bobbymckinney/seebeck_measurement/setup/TE_Poster_2016-07-22/2016-05-19 14.07.44.jpg

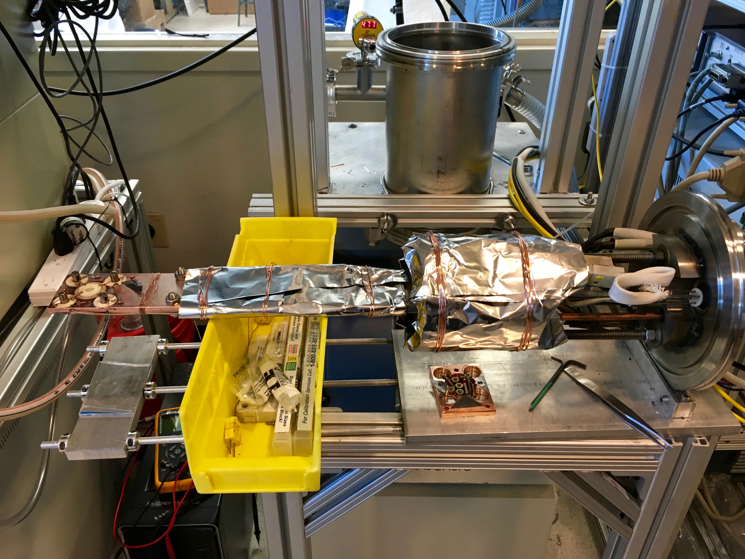
setup/TE_Poster_2016-07-22/2016-05-19 14.07.44.jpg
