bobbymckinney/seebeck_measurement/setup/TE_Poster_2016-07-22/2016-04-12 15.20.03.jpg

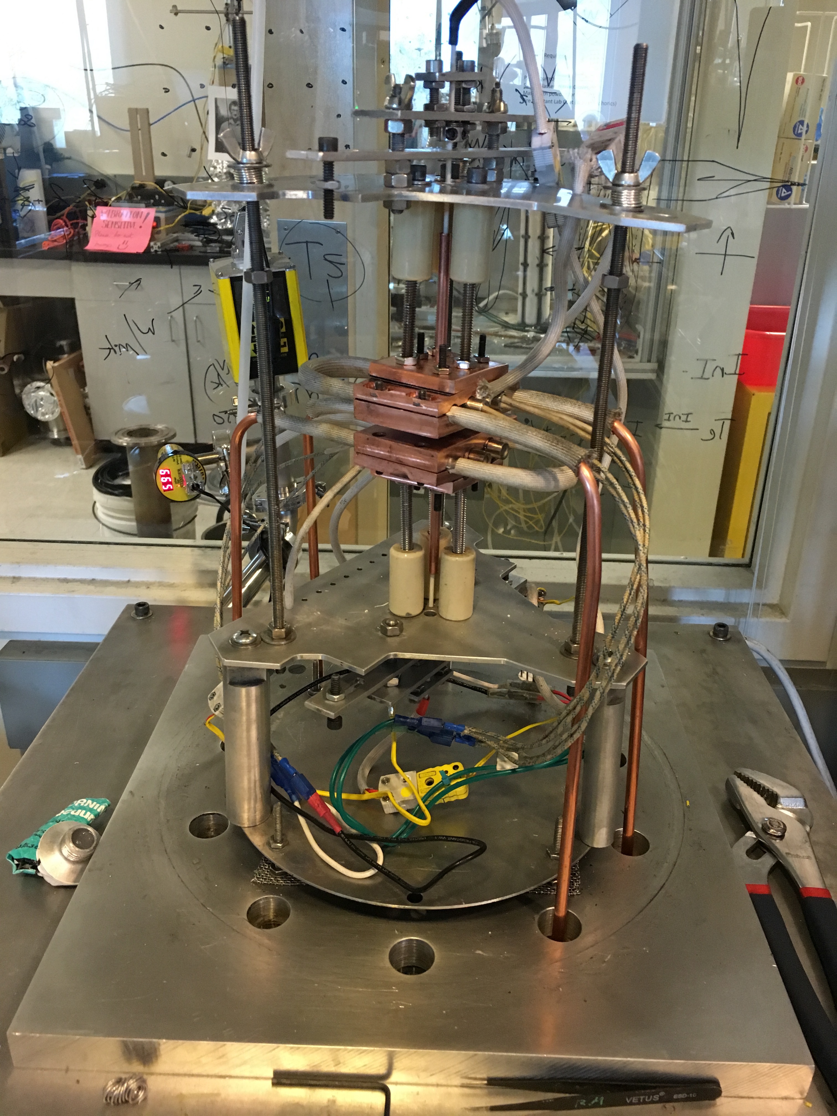
setup/TE_Poster_2016-07-22/2016-04-12 15.20.03.jpg
