bobbymckinney/seebeck_measurement/README.md

# seebeck_measurement

This project is for the measurement of the seebeck coefficient of thermoelectric materials.
