bobbymckinney/seebeck_measurement/program_roomtemp/copper_seebeck_calc/copper_seebeck_fig.png

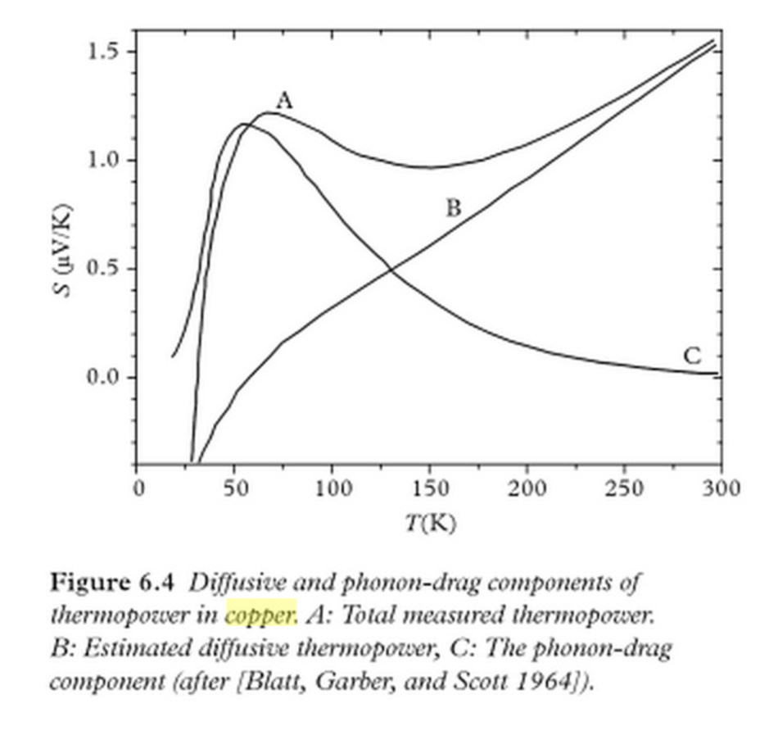
program_roomtemp/copper_seebeck_calc/copper_seebeck_fig.png
