bobbymckinney/seebeck_measurement/program_roomtemp/copper_seebeck_calc/copper_seebeck_fit_plot.png

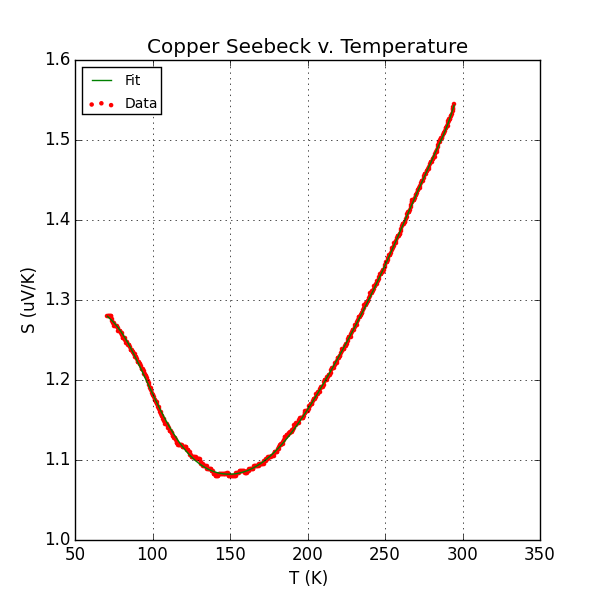
program_roomtemp/copper_seebeck_calc/copper_seebeck_fit_plot.png
