bobbymckinney/seebeck_measurement/programs/Alumel_Seebeck.png

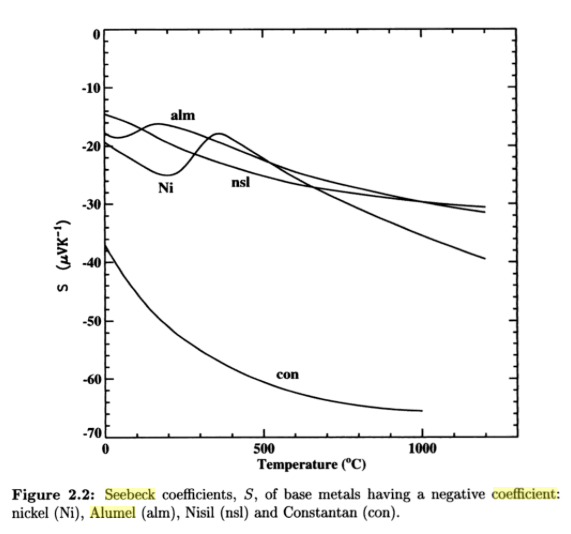
programs/Alumel_Seebeck.png
