bobbymckinney/seebeck_measurement/programs/Chromel_Seebeck.png

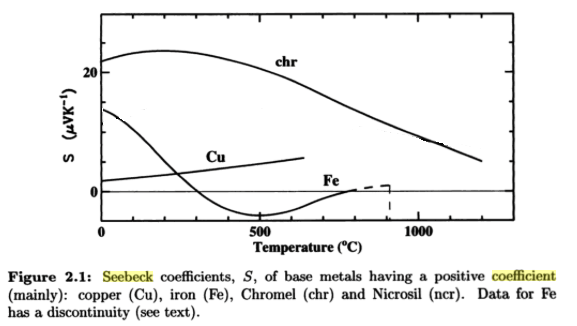
programs/Chromel_Seebeck.png
