bobbymckinney/seebeck_measurement/setup/TE_Poster_2016-07-22/carriertestdata.png

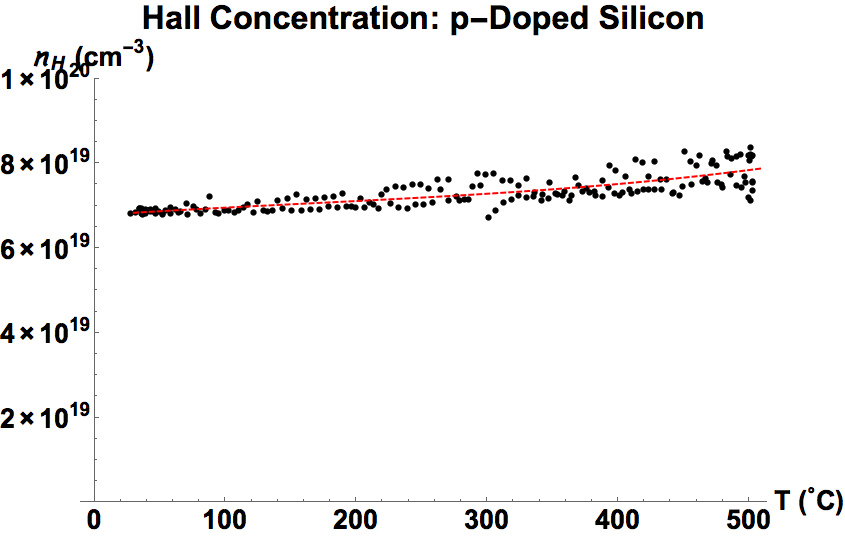
setup/TE_Poster_2016-07-22/carriertestdata.png
