bobbymckinney/seebeck_measurement/setup/hightemp2/seebeck_assembly_whole.SLDASM

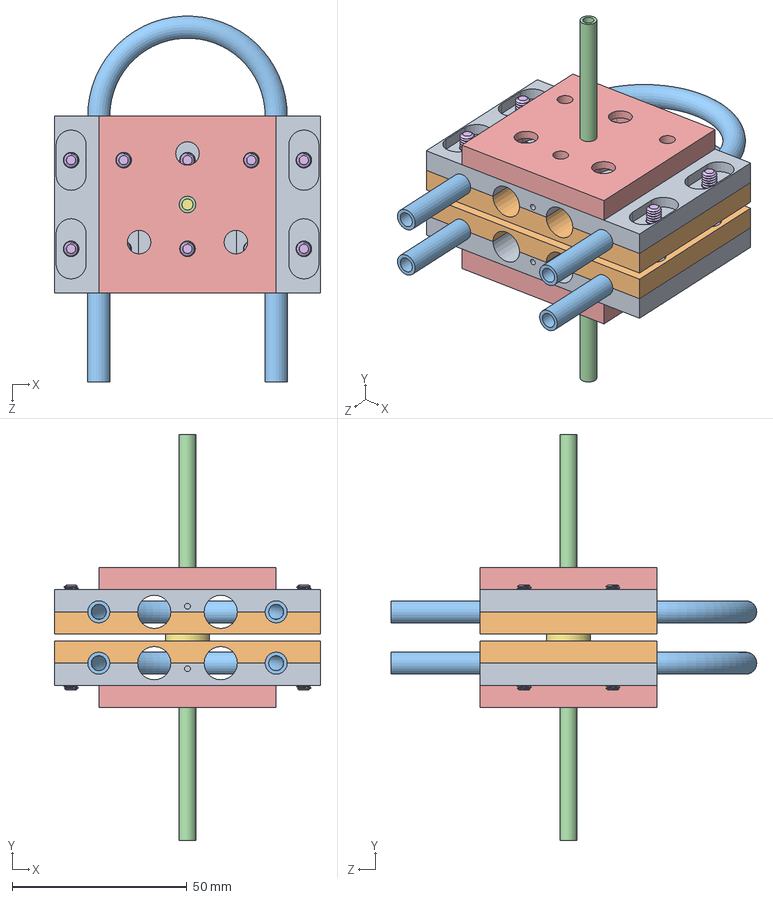
[picture p12: CAD file, 2016-08-10]
setup/hightemp2/seebeck_assembly_whole.SLDASM
76.2 x 116.3 x 104.7 mm
cu_block2 x 2
cu_block1 x 2
cu_tube_cool x 2
cu_tube x 2
ss_block3 x 2
832_screw x 20
example sample
