bobbymckinney/seebeck_measurement/setup/redesign_2-29-16/seebeck_block_assembly.SLDASM

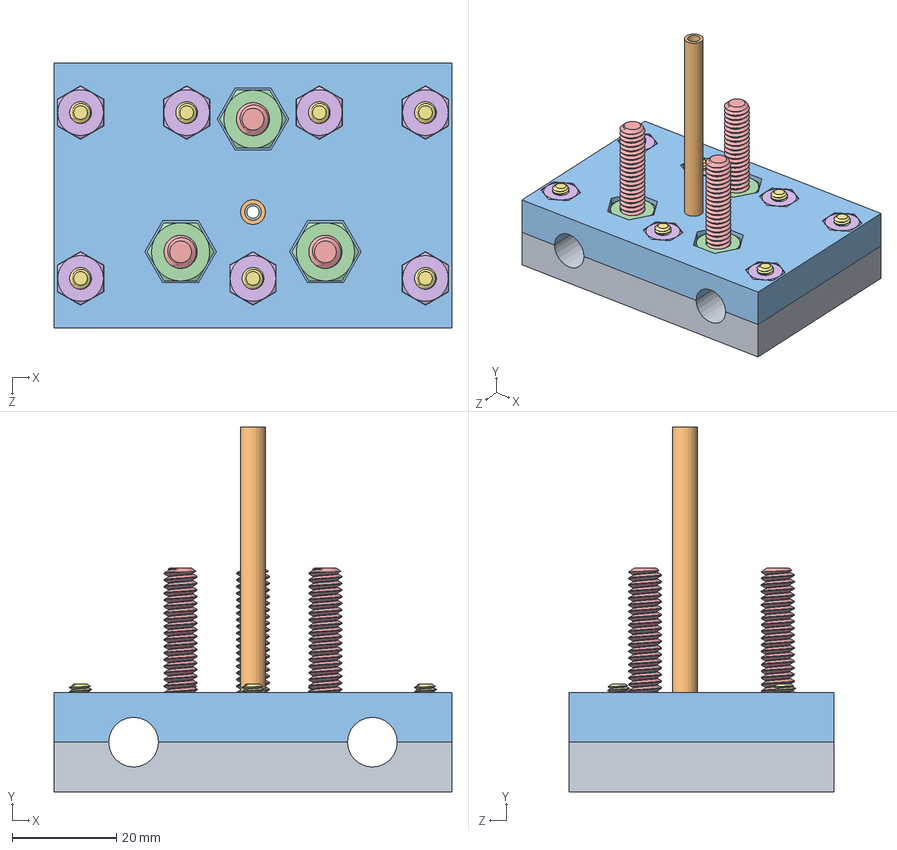
[picture p13: CAD file, 2016-08-10]
setup/redesign_2-29-16/seebeck_block_assembly.SLDASM
76.2 x 69.8 x 50.8 mm
block2
rod
block1
ss_nut_large x 3
ss_screw_large x 3
ss_nut_small x 7
ss_screw_small x 7
