bobbymckinney/seebeck_measurement/setup/hightemp2/seebeck_assembly.SLDASM

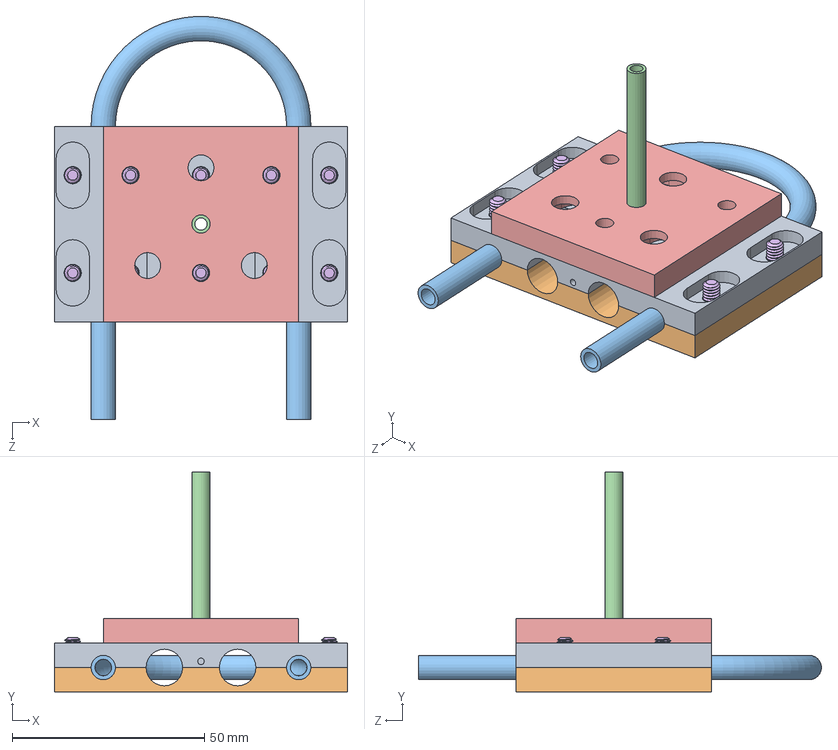
[picture p14: CAD file, 2016-08-10]
setup/hightemp2/seebeck_assembly.SLDASM
76.2 x 57.1 x 104.7 mm
cu_block2
cu_block1
cu_tube_cool
cu_tube
ss_block3
832_screw x 10
