bobbymckinney/seebeck_measurement/setup/lowtemp_design/lowtemp_assmbly.SLDASM

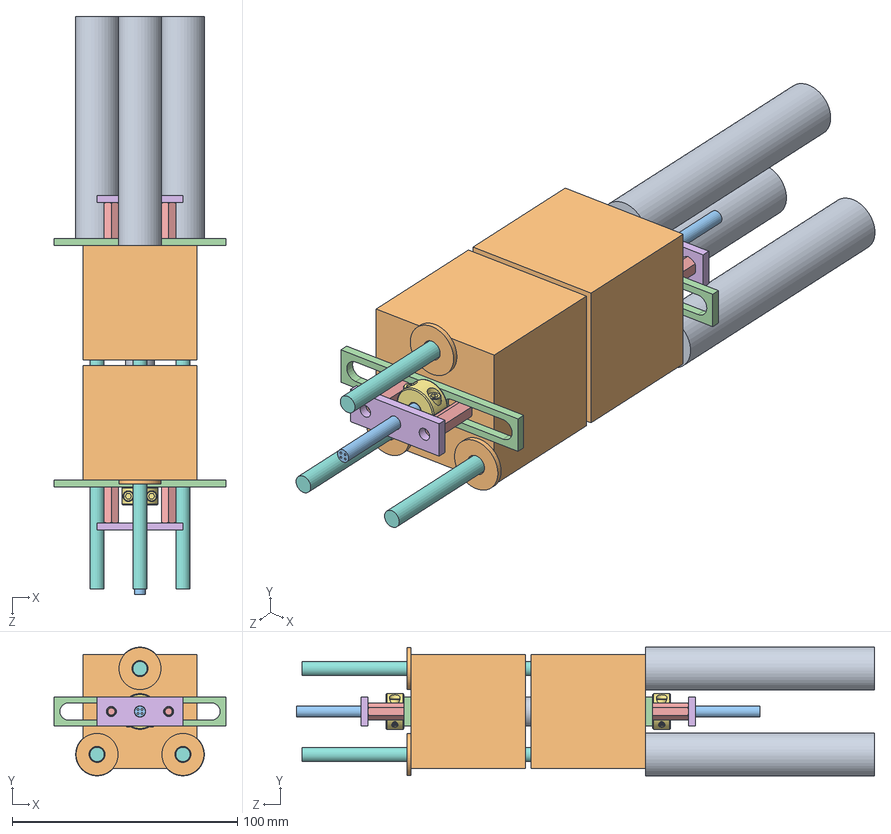
[picture p15: CAD file, 2016-01-14]
setup/lowtemp_design/lowtemp_assmbly.SLDASM
76.2 x 57.1 x 256.5 mm
ceramic_standoff x 3
copper_heater_block x 2
ceramic_thermocouple x 2
aluminum_long_plate x 2
aluminum_standoff x 4
aluminum_short_plate x 2
calmpon_shaft_collar x 2
threaded_rod x 3
example_sample
ceramic_washer x 3
