bobbymckinney/seebeck_measurement/setup/New Seebeck System Parts/New Seebeck System Assembly.SLDASM

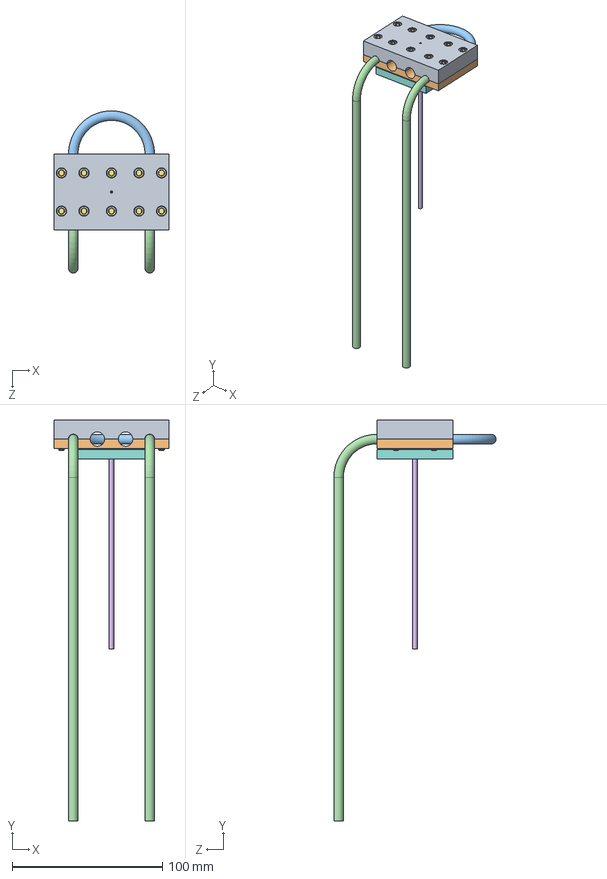
[picture p16: CAD file, 2016-08-10]
setup/New Seebeck System Parts/New Seebeck System Assembly.SLDASM
76.2 x 266.7 x 107.9 mm
Bottom Cu Block
Top Cu Block
Cu Cooling Pipe
Cu Cooling Pipe Extension x 2
Alumina Thermocouple
Copper Thermocouple Housing
832 .625in Length Screw x 10
Stainless Steel Mount
