bobbymckinney/seebeck_measurement/setup/David_test/Al_test1.SLDPRT

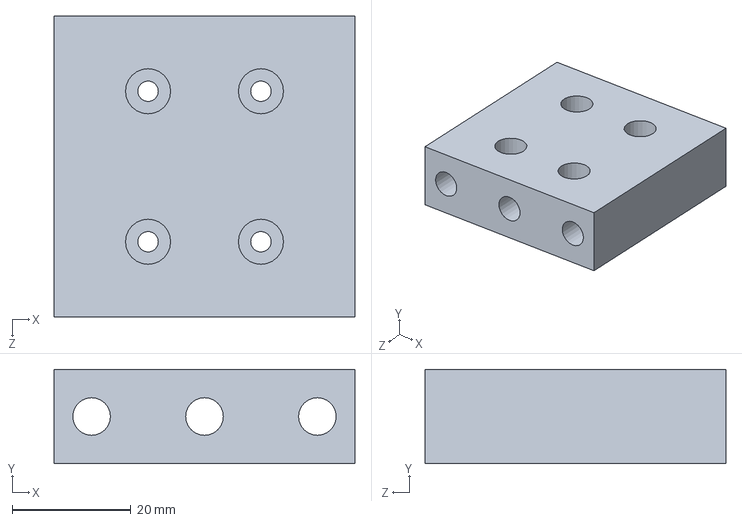
[picture p17: CAD file, 2016-08-10]
setup/David_test/Al_test1.SLDPRT
50.8 x 15.9 x 50.8 mm
