bobbymckinney/seebeck_measurement/setup/hightemp2/mastercam/ss_block3_bottom.SLDPRT

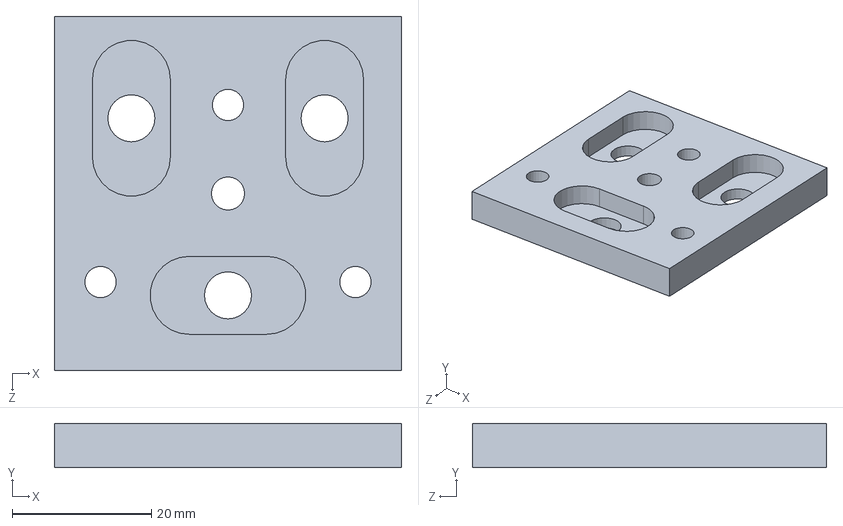
[picture p18: CAD file, 2016-08-10]
setup/hightemp2/mastercam/ss_block3_bottom.SLDPRT
49.8 x 6.35 x 50.8 mm
