bobbymckinney/seebeck_measurement/setup/lowtemp_design/aluminum plate.SLDPRT

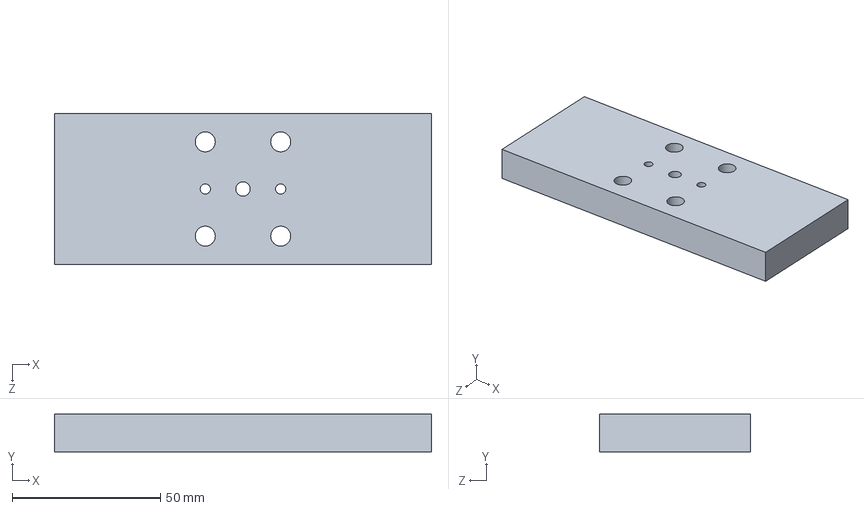
[picture p19: CAD file, 2016-08-10]
setup/lowtemp_design/aluminum plate.SLDPRT
127.0 x 12.7 x 50.8 mm
