bobbymckinney/seebeck_measurement/setup/New Seebeck System Parts/Bottom SS Disk.SLDPRT

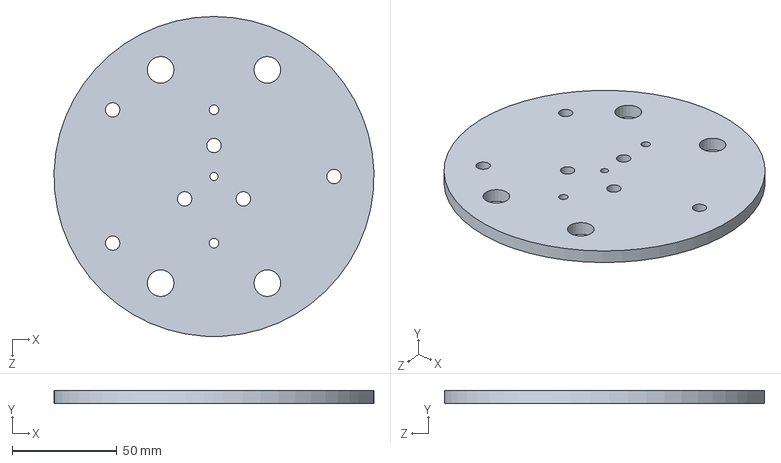
[picture p20: CAD file, 2016-08-10]
setup/New Seebeck System Parts/Bottom SS Disk.SLDPRT
152.3 x 6.35 x 152.4 mm
