bobbymckinney/seebeck_measurement/setup/hightemp2/cu_block2.SLDPRT

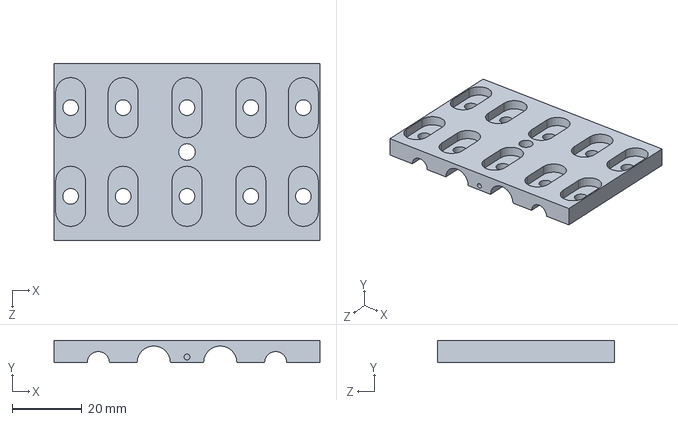
[picture p21: CAD file, 2016-08-10]
setup/hightemp2/cu_block2.SLDPRT
76.2 x 6.35 x 50.8 mm
