bobbymckinney/seebeck_measurement/setup/lowtemp_design/plastic_spacer.SLDPRT

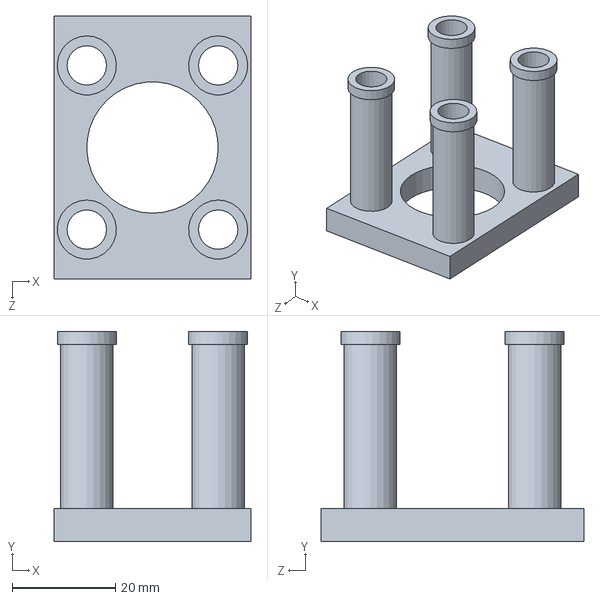
[picture p23: CAD file, 2016-08-10]
setup/lowtemp_design/plastic_spacer.SLDPRT
38.1 x 40.6 x 50.8 mm
