bobbymckinney/seebeck_measurement/setup/New Seebeck System Parts/Copper Thermocouple Housing.SLDPRT

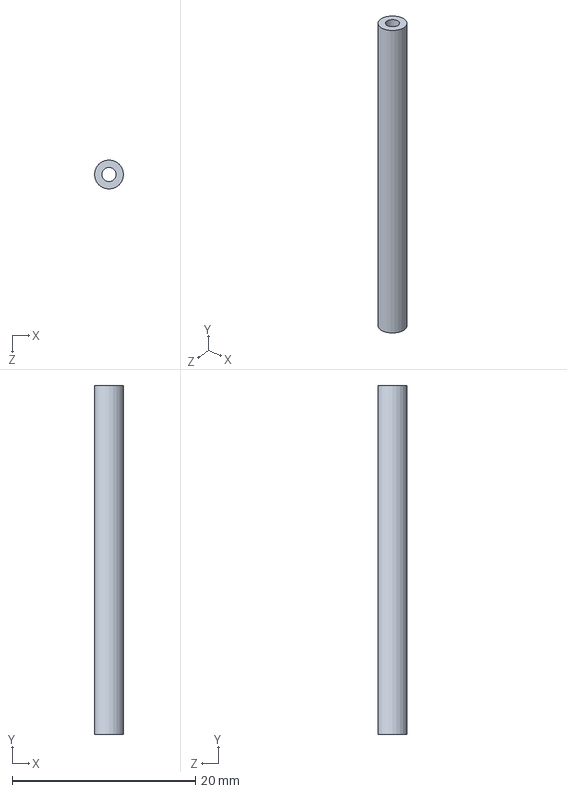
[picture p24: CAD file, 2016-08-10]
setup/New Seebeck System Parts/Copper Thermocouple Housing.SLDPRT
3.17 x 38.1 x 3.17 mm
