bobbymckinney/seebeck_measurement/setup/hightemp2/cu_tube.SLDPRT

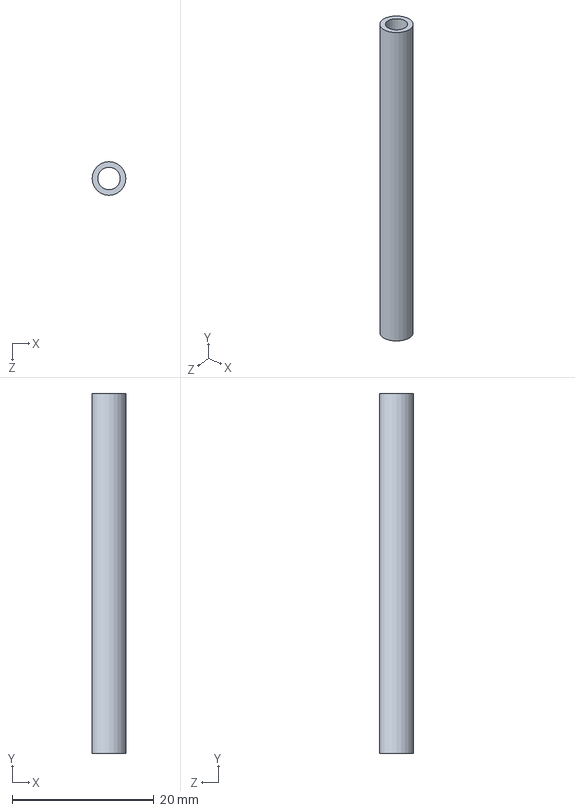
[picture p25: CAD file, 2016-08-10]
setup/hightemp2/cu_tube.SLDPRT
4.76 x 50.8 x 4.76 mm
