bobbymckinney/seebeck_measurement/setup/hightemp2/mastercam/cu_block2_top_holes.SLDPRT

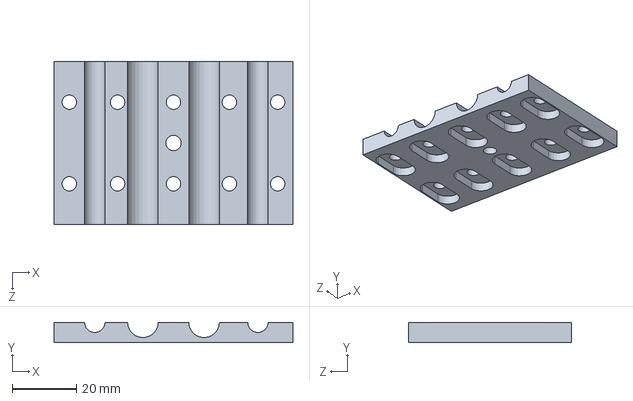
[picture p26: CAD file, 2016-08-10]
setup/hightemp2/mastercam/cu_block2_top_holes.SLDPRT
74.4 x 6.35 x 50.8 mm
