bobbymckinney/seebeck_measurement/setup/lowtemp_design/copper_heater_block.SLDPRT

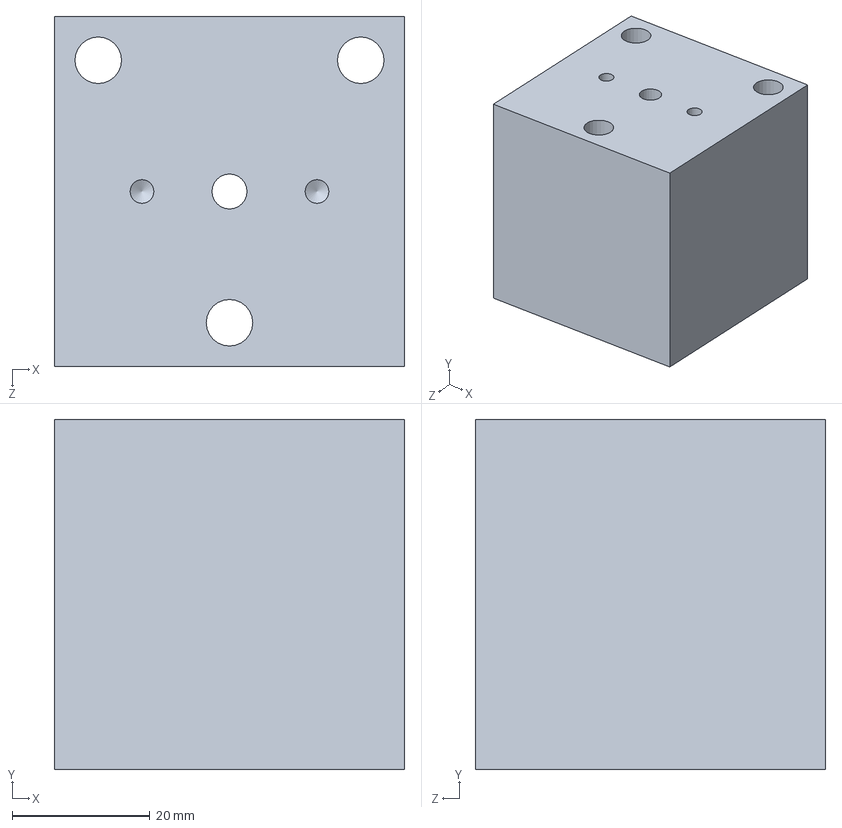
[picture p27: CAD file, 2016-08-10]
setup/lowtemp_design/copper_heater_block.SLDPRT
50.8 x 50.8 x 50.8 mm
