bobbymckinney/seebeck_measurement/setup/lowtemp_design/compression spring.SLDPRT

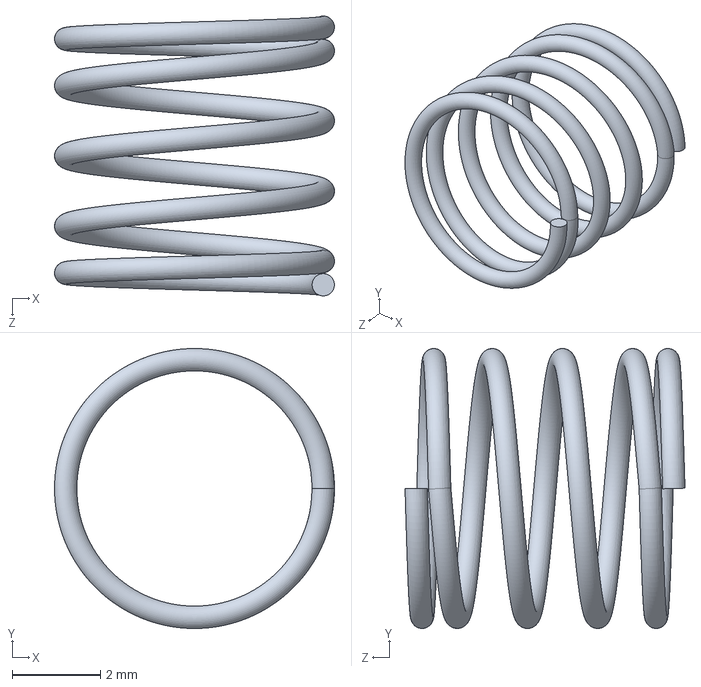
[picture p28: CAD file, 2016-01-14]
setup/lowtemp_design/compression spring.SLDPRT
6.35 x 6.35 x 6.35 mm
