bobbymckinney/seebeck_measurement/setup/hightemp2/example sample.SLDPRT

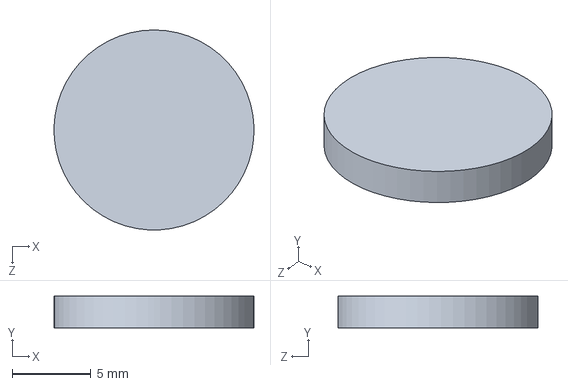
[picture p29: CAD file, 2016-08-10]
setup/hightemp2/example sample.SLDPRT
12.7 x 2.00 x 12.7 mm
