bobbymckinney/seebeck_measurement/setup/lowtemp_design/aluminum_standoff.SLDPRT

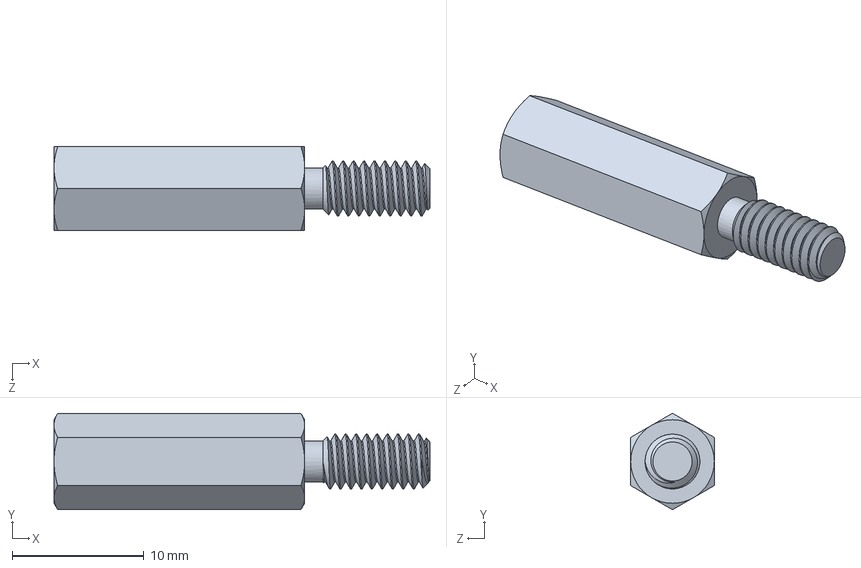
[picture p30: CAD file, 2016-01-14]
setup/lowtemp_design/aluminum_standoff.SLDPRT
28.6 x 7.33 x 6.35 mm
