bobbymckinney/seebeck_measurement/setup/New Seebeck System Parts/Top Thermocouple Bar.SLDPRT

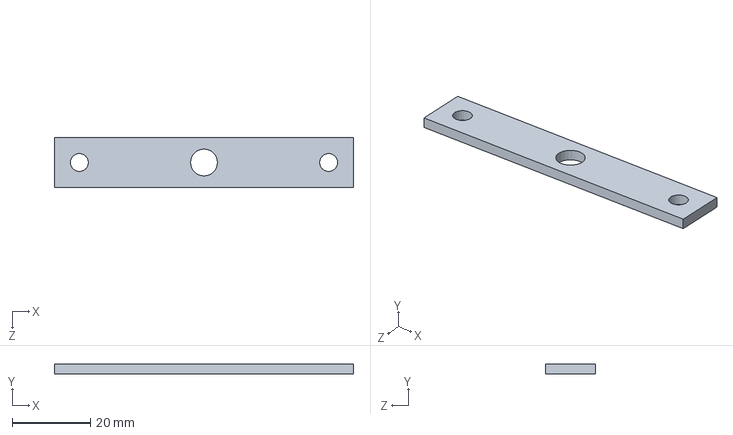
[picture p31: CAD file, 2016-08-10]
setup/New Seebeck System Parts/Top Thermocouple Bar.SLDPRT
76.2 x 2.54 x 12.7 mm
