bobbymckinney/seebeck_measurement/setup/redesign_2-29-16/rod.SLDPRT

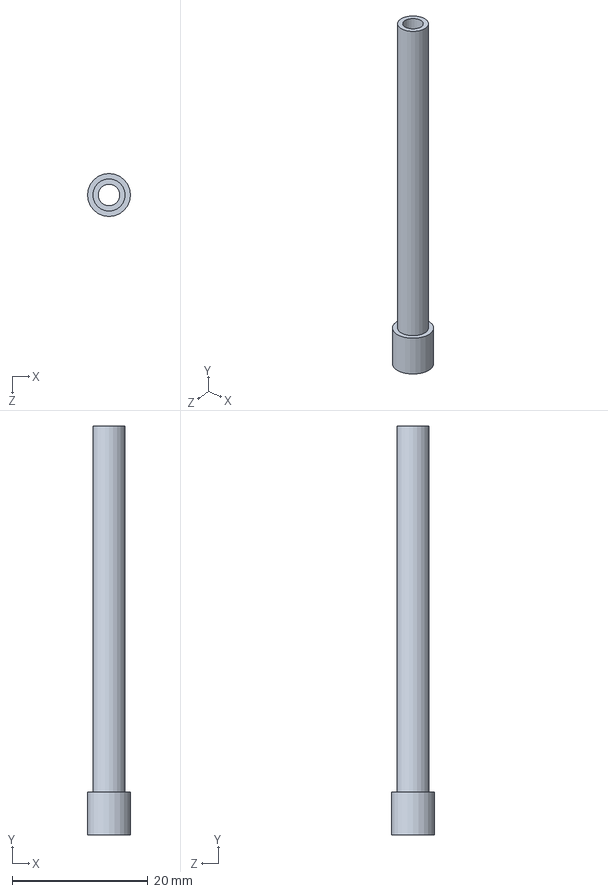
[picture p32: CAD file, 2016-08-10]
setup/redesign_2-29-16/rod.SLDPRT
6.35 x 60.3 x 6.35 mm
