bobbymckinney/seebeck_measurement/setup/hightemp2/ss_block3.SLDPRT

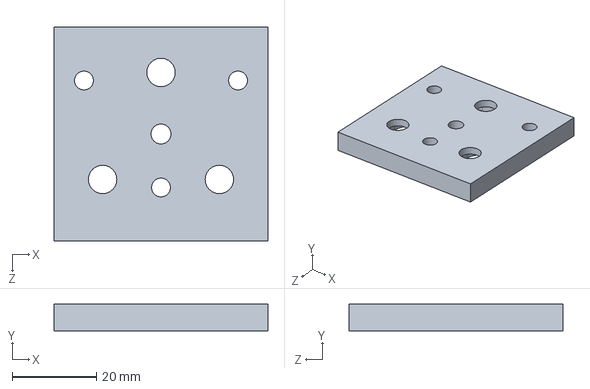
[picture p33: CAD file, 2016-08-10]
setup/hightemp2/ss_block3.SLDPRT
50.8 x 6.35 x 50.8 mm
