bobbymckinney/seebeck_measurement/setup/New Seebeck System Parts/New Flange ISO250.SLDPRT

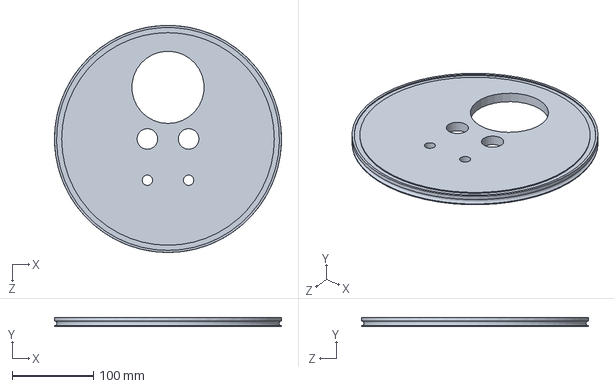
[picture p34: CAD file, 2016-08-10]
setup/New Seebeck System Parts/New Flange ISO250.SLDPRT
279.3 x 11.1 x 279.3 mm
