bobbymckinney/seebeck_measurement/setup/lowtemp_design/aluminum_short_plate.SLDPRT

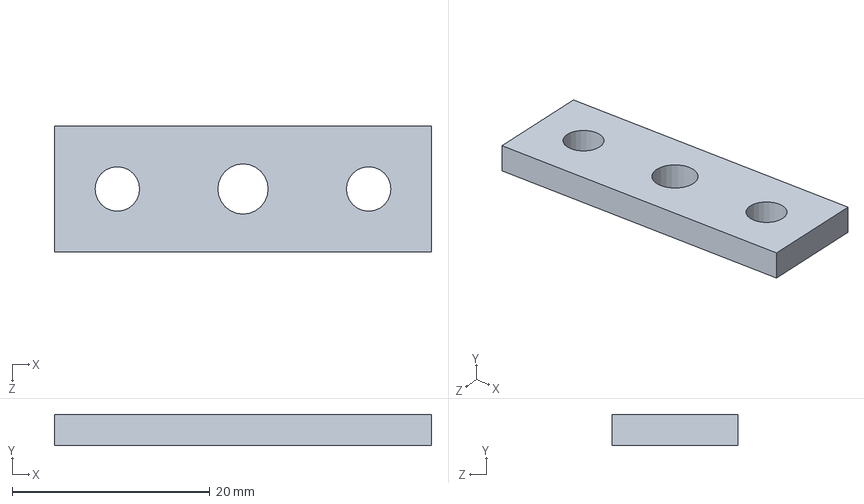
[picture p35: CAD file, 2016-01-14]
setup/lowtemp_design/aluminum_short_plate.SLDPRT
38.1 x 3.17 x 12.7 mm
