bobbymckinney/seebeck_measurement/setup/lowtemp_design/example_sample.SLDPRT

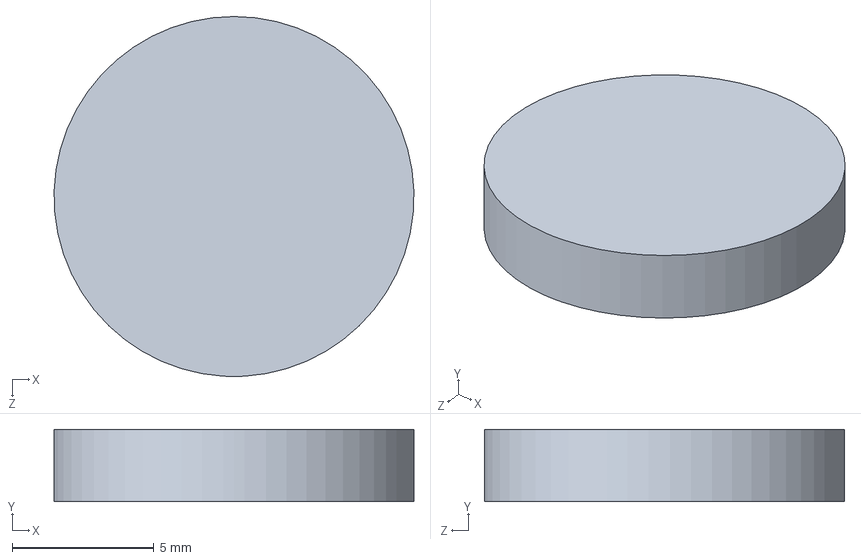
[picture p36: CAD file, 2016-01-14]
setup/lowtemp_design/example_sample.SLDPRT
12.7 x 2.54 x 12.7 mm
