bobbymckinney/seebeck_measurement/setup/New Seebeck System Parts/SS .5in Standoff.SLDPRT

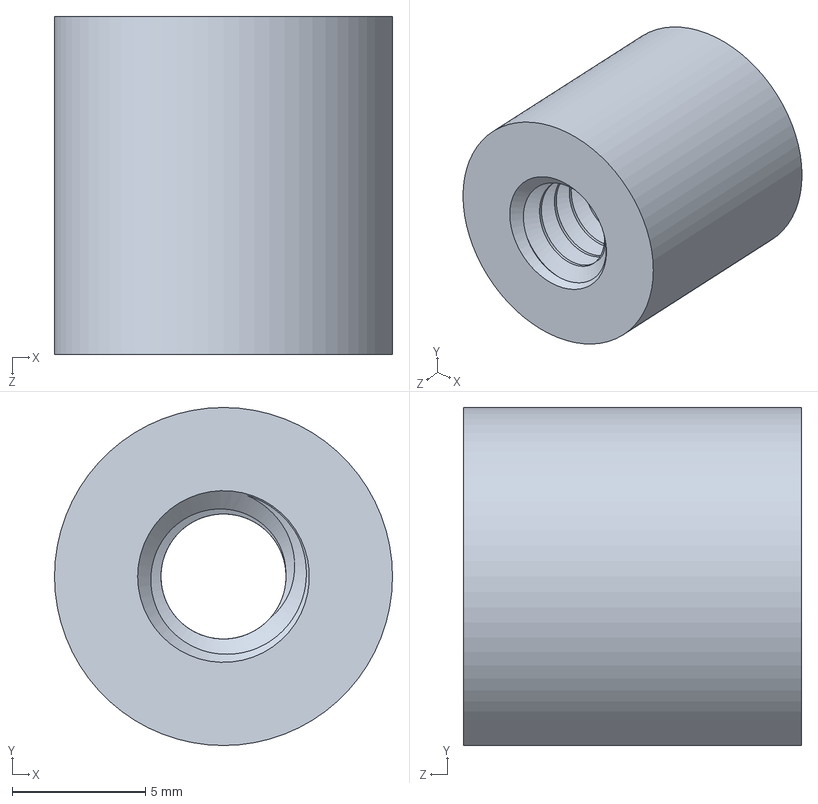
[picture p37: CAD file, 2016-08-10]
setup/New Seebeck System Parts/SS .5in Standoff.SLDPRT
12.7 x 12.7 x 12.7 mm
