bobbymckinney/seebeck_measurement/setup/redesign_2-29-16/block2.SLDPRT

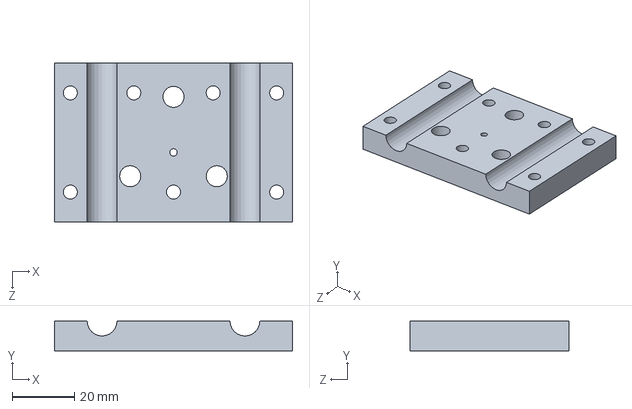
[picture p38: CAD file, 2016-08-10]
setup/redesign_2-29-16/block2.SLDPRT
76.2 x 9.53 x 50.8 mm
