bobbymckinney/seebeck_measurement/setup/hightemp2/cu_block1.SLDPRT

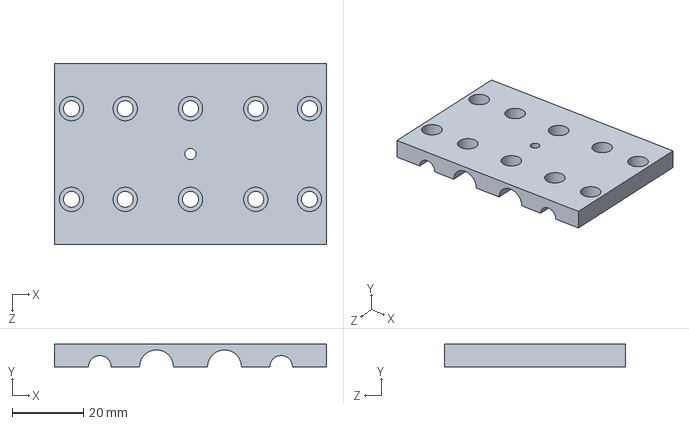
[picture p39: CAD file, 2016-08-10]
setup/hightemp2/cu_block1.SLDPRT
76.2 x 6.35 x 50.8 mm
