bobbymckinney/seebeck_measurement/setup/New Seebeck System Parts/Aluminum Base.SLDPRT

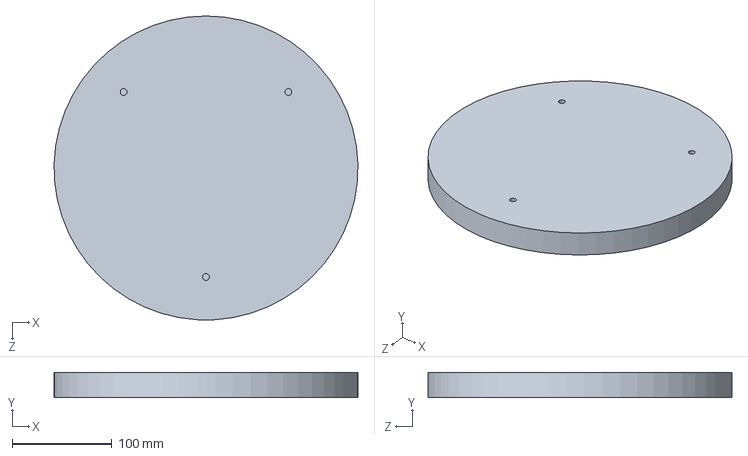
[picture p40: CAD file, 2016-08-10]
setup/New Seebeck System Parts/Aluminum Base.SLDPRT
304.7 x 25.4 x 304.8 mm
