bobbymckinney/seebeck_measurement/setup/lowtemp_design/calmpon_shaft_collar.SLDPRT

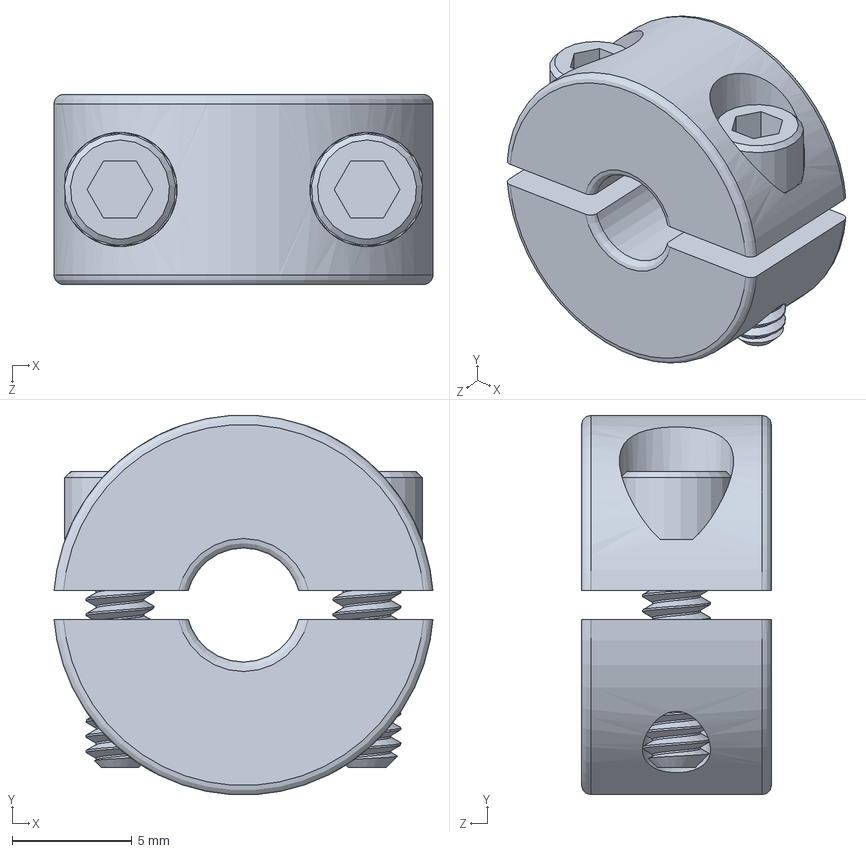
[picture p41: CAD file, 2016-01-14]
setup/lowtemp_design/calmpon_shaft_collar.SLDPRT
15.8 x 15.8 x 7.94 mm
