bobbymckinney/seebeck_measurement/setup/New Seebeck System Parts/Alumina Thermocouple.SLDPRT

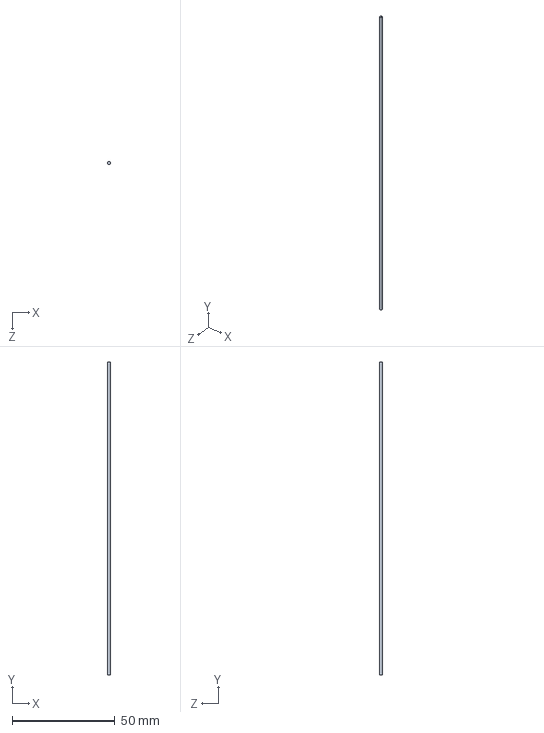
[picture p42: CAD file, 2016-08-10]
setup/New Seebeck System Parts/Alumina Thermocouple.SLDPRT
1.57 x 152.4 x 1.57 mm
