bobbymckinney/seebeck_measurement/setup/hightemp2/cu_tube_cool.SLDPRT

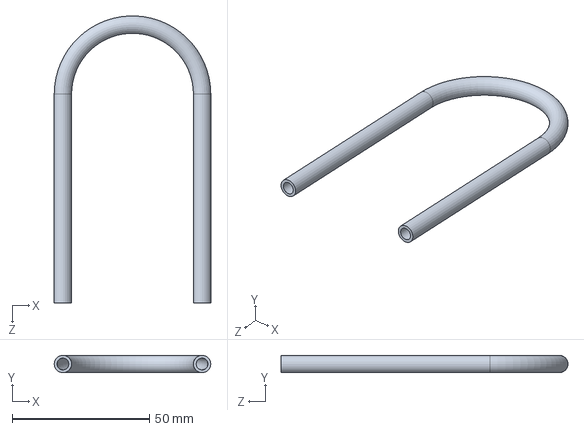
[picture p43: CAD file, 2016-08-10]
setup/hightemp2/cu_tube_cool.SLDPRT
57.1 x 6.35 x 104.7 mm
