bobbymckinney/seebeck_measurement/setup/lowtemp_design/ceramic_thermocouple.SLDPRT

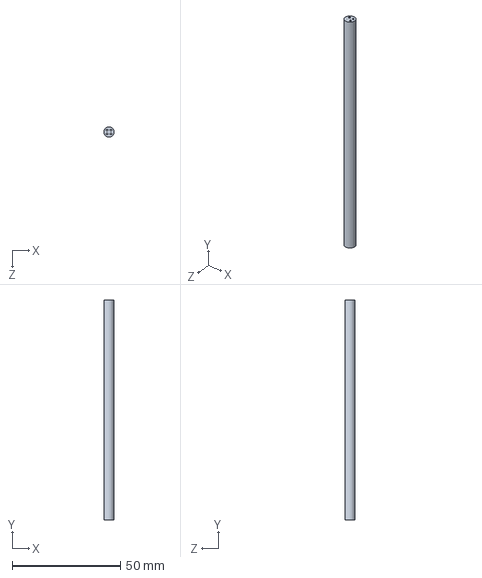
[picture p44: CAD file, 2016-01-14]
setup/lowtemp_design/ceramic_thermocouple.SLDPRT
4.78 x 101.6 x 4.78 mm
