bobbymckinney/seebeck_measurement/setup/New Seebeck System Parts/ISO80 Half Nipple.SLDPRT

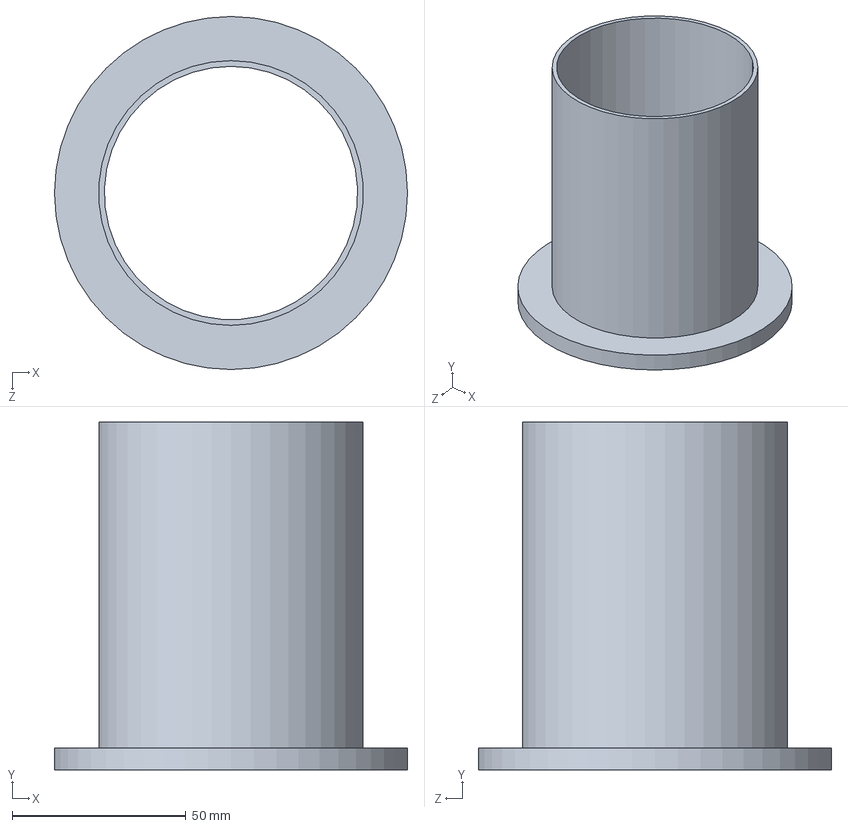
[picture p45: CAD file, 2016-08-10]
setup/New Seebeck System Parts/ISO80 Half Nipple.SLDPRT
101.6 x 100.1 x 101.6 mm
