bobbymckinney/seebeck_measurement/setup/lowtemp_design/threaded_rod.SLDPRT

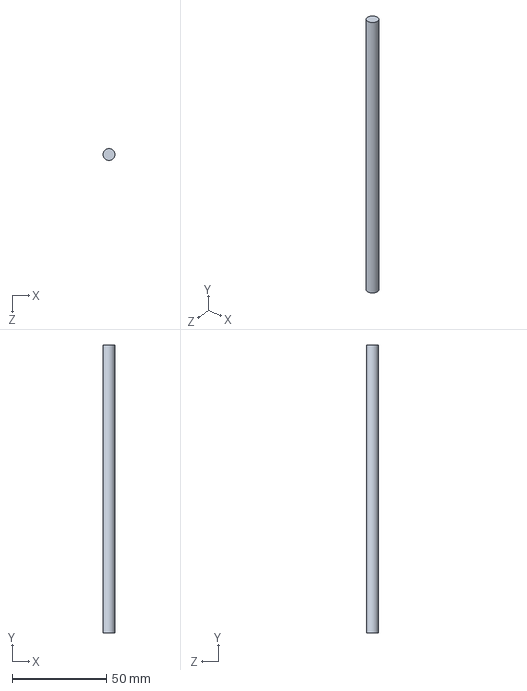
[picture p46: CAD file, 2016-01-14]
setup/lowtemp_design/threaded_rod.SLDPRT
6.35 x 152.4 x 6.35 mm
