bobbymckinney/seebeck_measurement/setup/New Seebeck System Parts/Bottom Cu Block.SLDPRT

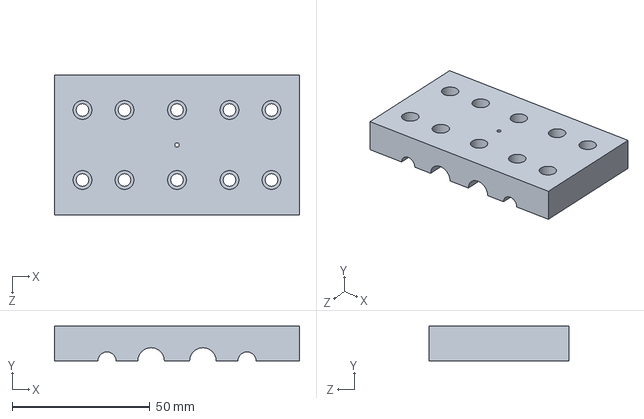
[picture p47: CAD file, 2016-08-10]
setup/New Seebeck System Parts/Bottom Cu Block.SLDPRT
88.9 x 12.7 x 50.8 mm
