bobbymckinney/seebeck_measurement/setup/lowtemp_design/aluminum_long_plate.SLDPRT

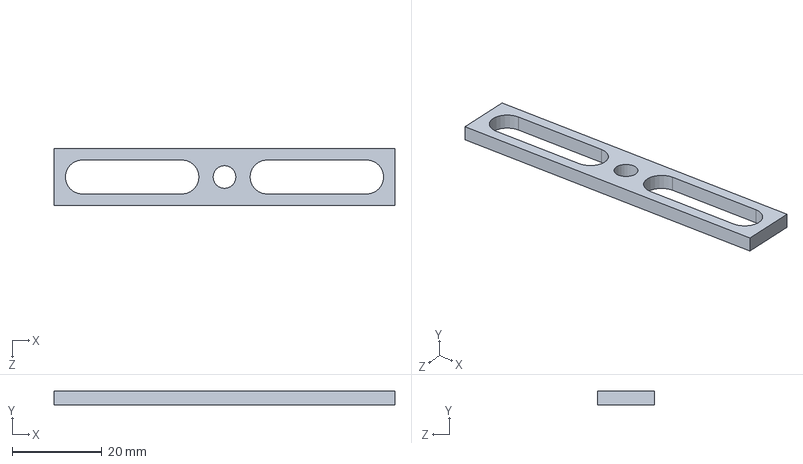
[picture p48: CAD file, 2016-01-14]
setup/lowtemp_design/aluminum_long_plate.SLDPRT
76.2 x 3.17 x 12.7 mm
