bobbymckinney/seebeck_measurement/setup/New Seebeck System Parts/Cu Cooling Pipe.SLDPRT

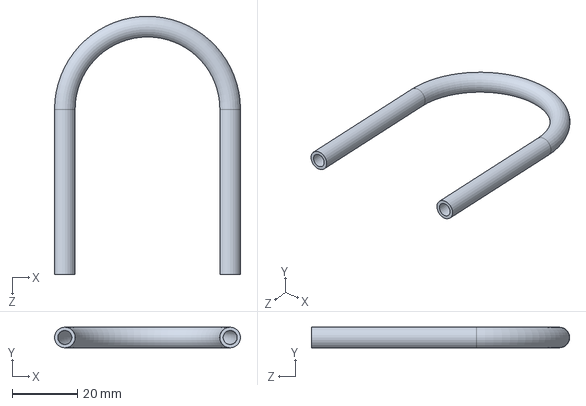
[picture p49: CAD file, 2016-08-10]
setup/New Seebeck System Parts/Cu Cooling Pipe.SLDPRT
57.1 x 6.35 x 79.4 mm
