bobbymckinney/seebeck_measurement/setup/lowtemp_design/ceramic_standoff.SLDPRT

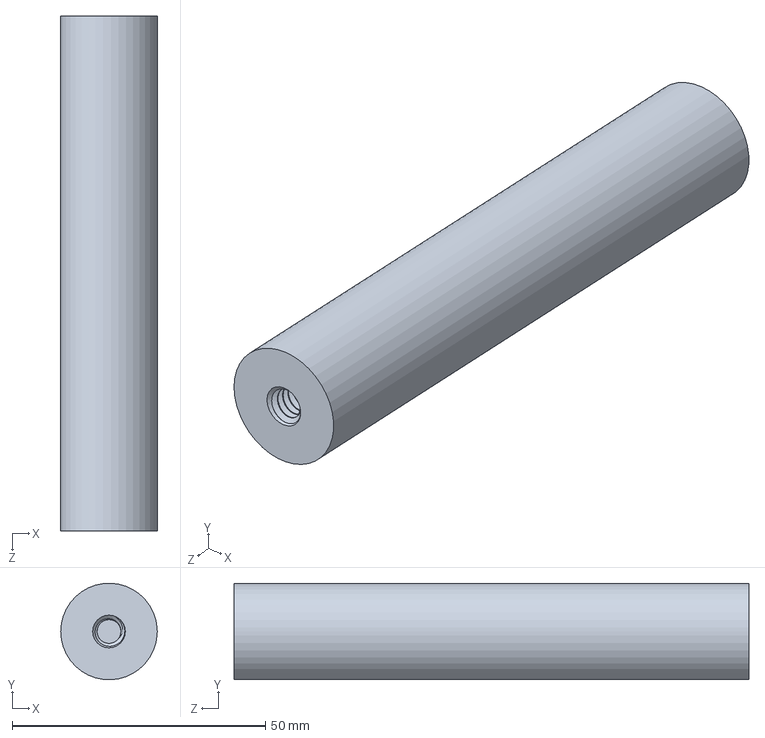
[picture p50: CAD file, 2016-01-14]
setup/lowtemp_design/ceramic_standoff.SLDPRT
19.1 x 19.0 x 101.6 mm
