bobbymckinney/seebeck_measurement/setup/New Seebeck System Parts/Bottom Thermocouple Bar.SLDPRT

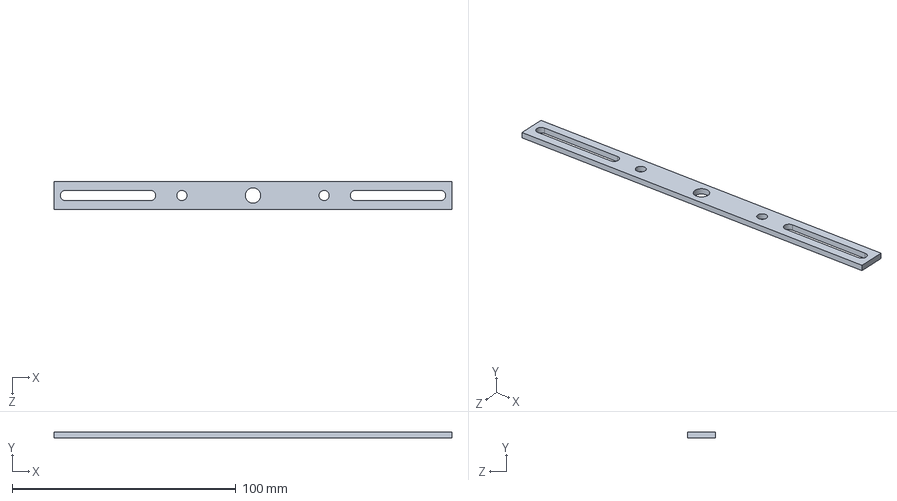
[picture p51: CAD file, 2016-08-10]
setup/New Seebeck System Parts/Bottom Thermocouple Bar.SLDPRT
177.8 x 2.54 x 12.7 mm
