bobbymckinney/seebeck_measurement/setup/New Seebeck System Parts/Quarter 20 Standoff Adapter.SLDPRT

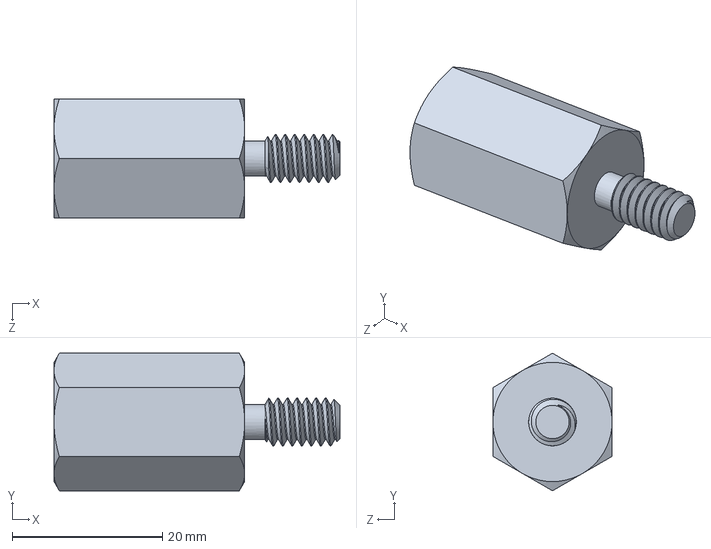
[picture p52: CAD file, 2016-08-10]
setup/New Seebeck System Parts/Quarter 20 Standoff Adapter.SLDPRT
38.1 x 18.3 x 15.9 mm
