bobbymckinney/seebeck_measurement/setup/New Seebeck System Parts/ISO-K Blank Flange Top.SLDPRT

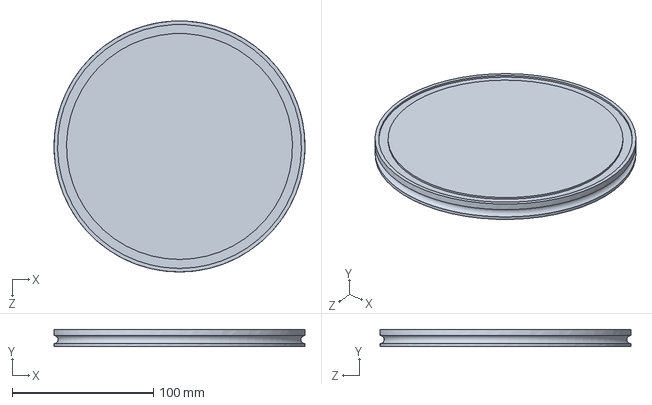
[picture p53: CAD file, 2016-08-10]
setup/New Seebeck System Parts/ISO-K Blank Flange Top.SLDPRT
177.8 x 12.1 x 177.7 mm
