bobbymckinney/seebeck_measurement/setup/New Seebeck System Parts/Quarter 20 1in Rod.SLDPRT

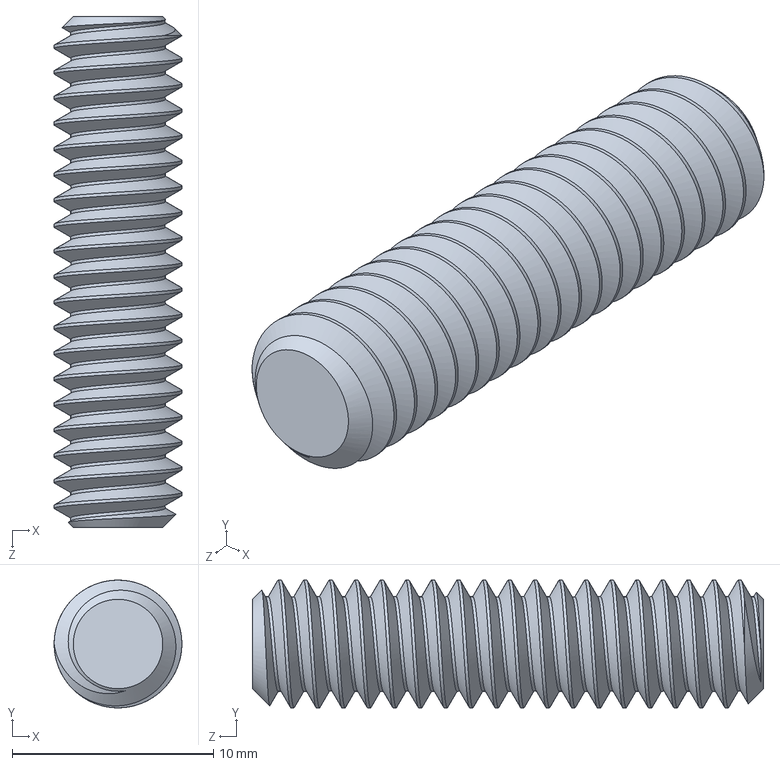
[picture p54: CAD file, 2016-08-10]
setup/New Seebeck System Parts/Quarter 20 1in Rod.SLDPRT
6.35 x 6.35 x 25.4 mm
