bobbymckinney/seebeck_measurement/setup/New Seebeck System Parts/3 Way 8020 Connector.SLDPRT

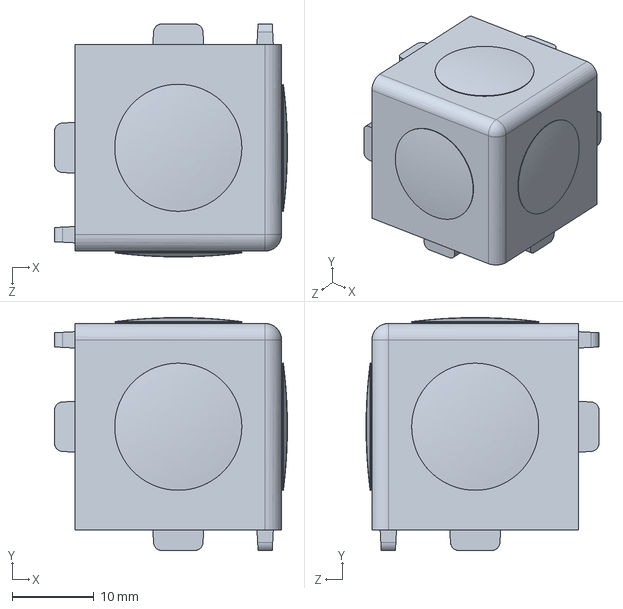
[picture p55: CAD file, 2016-08-10]
setup/New Seebeck System Parts/3 Way 8020 Connector.SLDPRT
28.4 x 28.4 x 28.4 mm
