bobbymckinney/seebeck_measurement/setup/New Seebeck System Parts/Cu Cooling Pipe Extension.SLDPRT

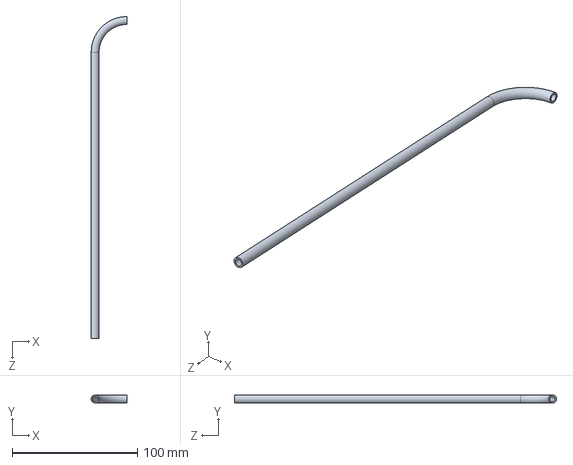
[picture p56: CAD file, 2016-08-10]
setup/New Seebeck System Parts/Cu Cooling Pipe Extension.SLDPRT
28.6 x 6.35 x 257.2 mm
