bobbymckinney/seebeck_measurement/setup/New Seebeck System Parts/820 90 Degree Plate.SLDPRT

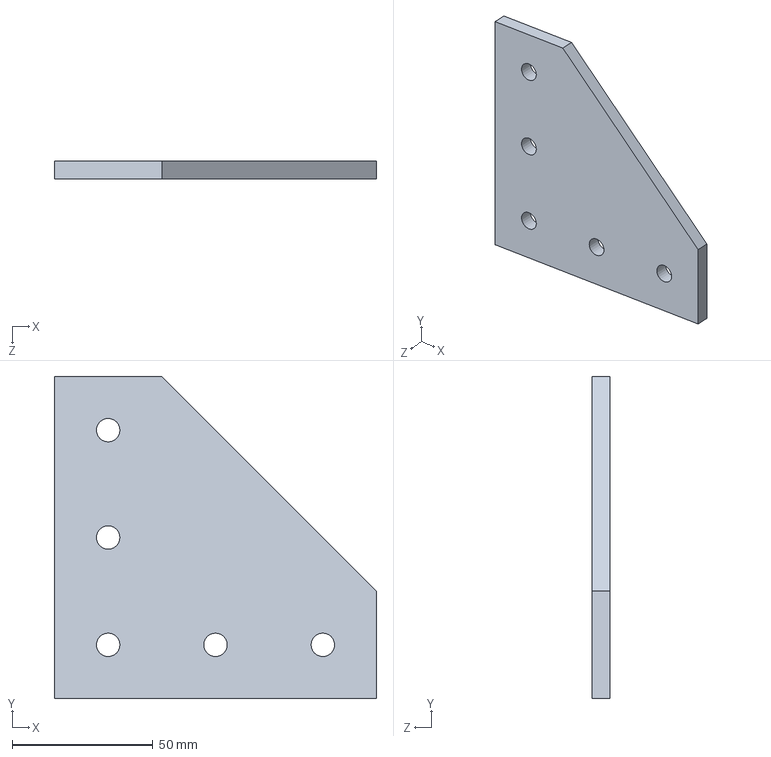
[picture p57: CAD file, 2016-08-10]
setup/New Seebeck System Parts/820 90 Degree Plate.SLDPRT
114.3 x 114.3 x 6.35 mm
