bobbymckinney/seebeck_measurement/setup/New Seebeck System Parts/Vacuum Chamber.SLDPRT

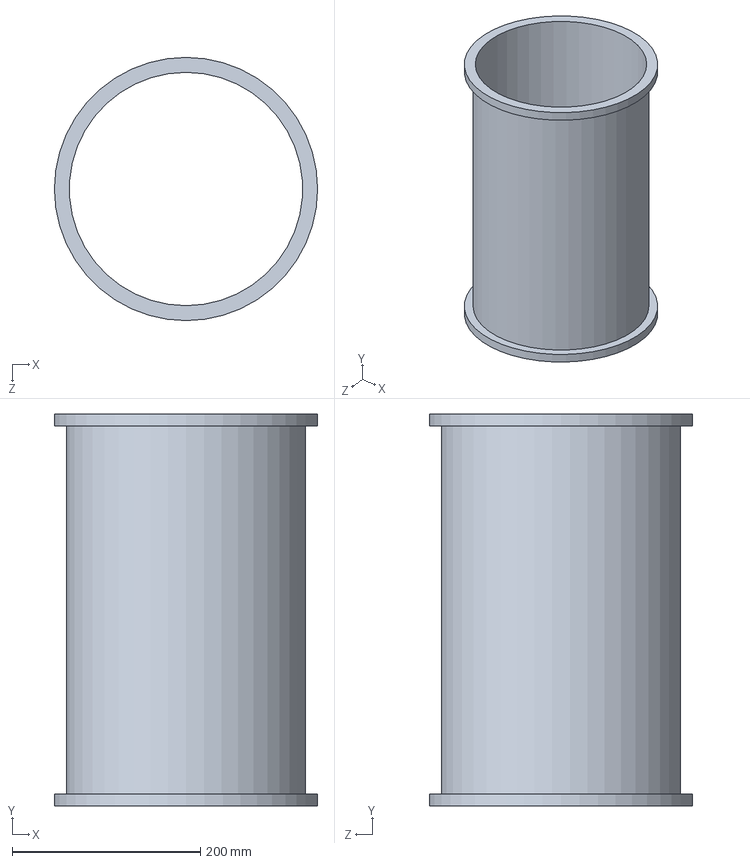
[picture p58: CAD file, 2016-08-10]
setup/New Seebeck System Parts/Vacuum Chamber.SLDPRT
279.4 x 416.1 x 279.4 mm
