bobbymckinney/seebeck_measurement/setup/New Seebeck System Parts/KF25 Half Nipple.SLDPRT

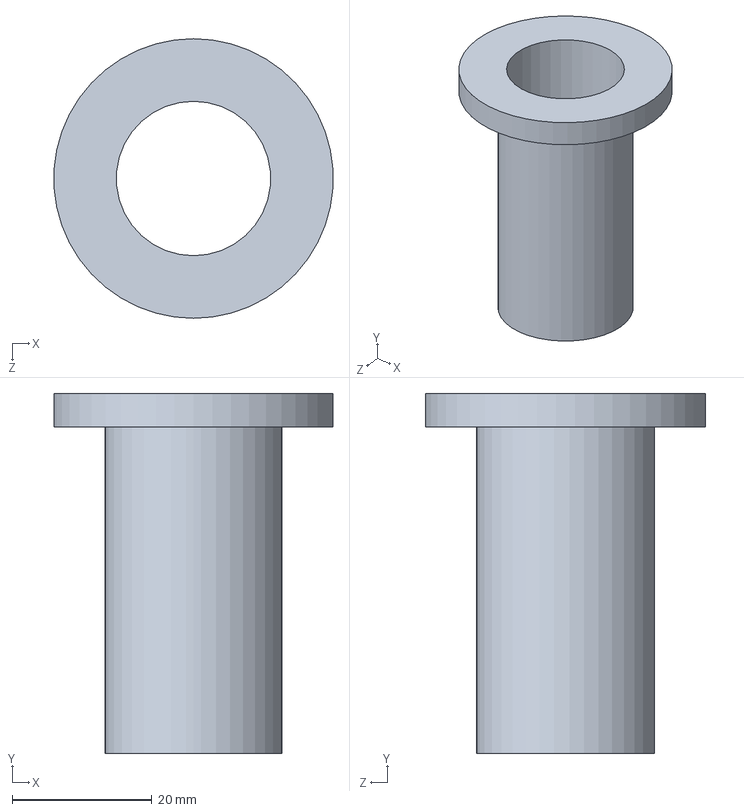
[picture p59: CAD file, 2016-08-10]
setup/New Seebeck System Parts/KF25 Half Nipple.SLDPRT
39.9 x 51.5 x 40.0 mm
