bobbymckinney/seebeck_measurement/setup/New Seebeck System Parts/Quarter 20 Male-Female Standoff.SLDPRT

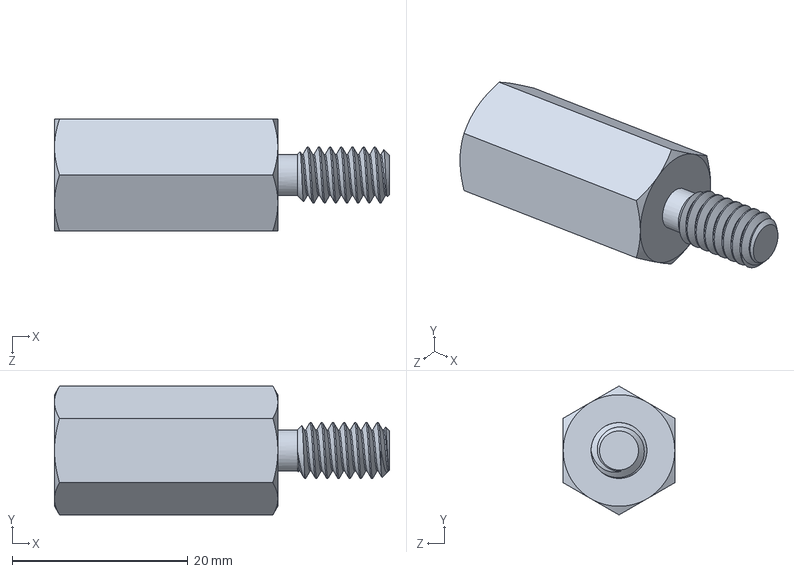
[picture p60: CAD file, 2016-08-10]
setup/New Seebeck System Parts/Quarter 20 Male-Female Standoff.SLDPRT
38.1 x 14.7 x 12.7 mm
