bobbymckinney/seebeck_measurement/setup/New Seebeck System Parts/Cooper Cooling Arc.SLDPRT

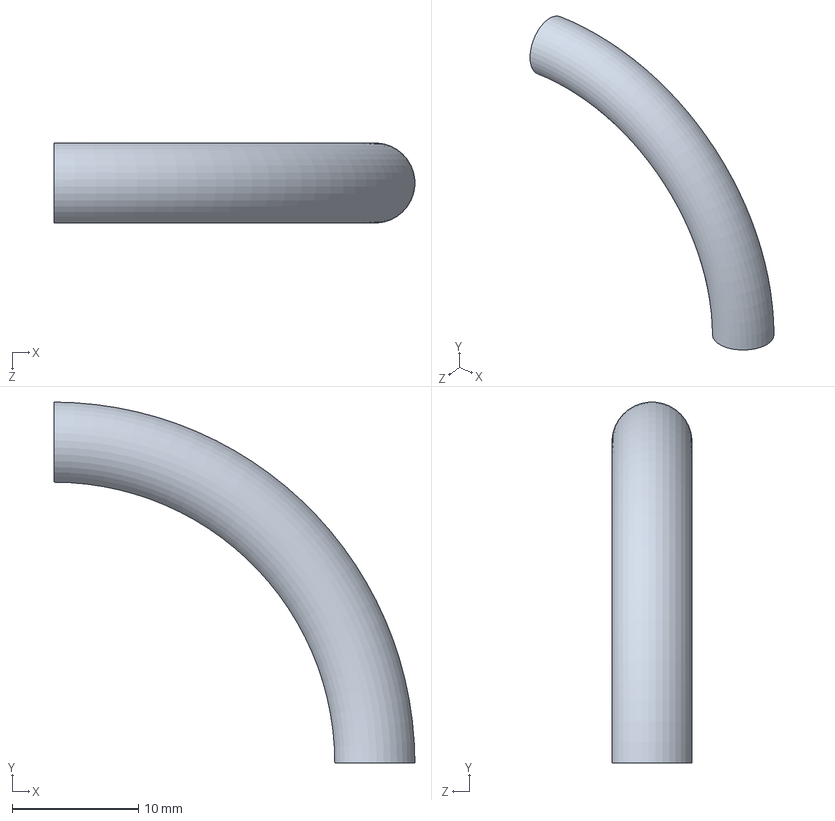
[picture p61: CAD file, 2016-08-10]
setup/New Seebeck System Parts/Cooper Cooling Arc.SLDPRT
28.6 x 28.6 x 6.34 mm
