bobbymckinney/seebeck_measurement/setup/New Seebeck System Parts/yor-lok butt weld fitting.SLDPRT

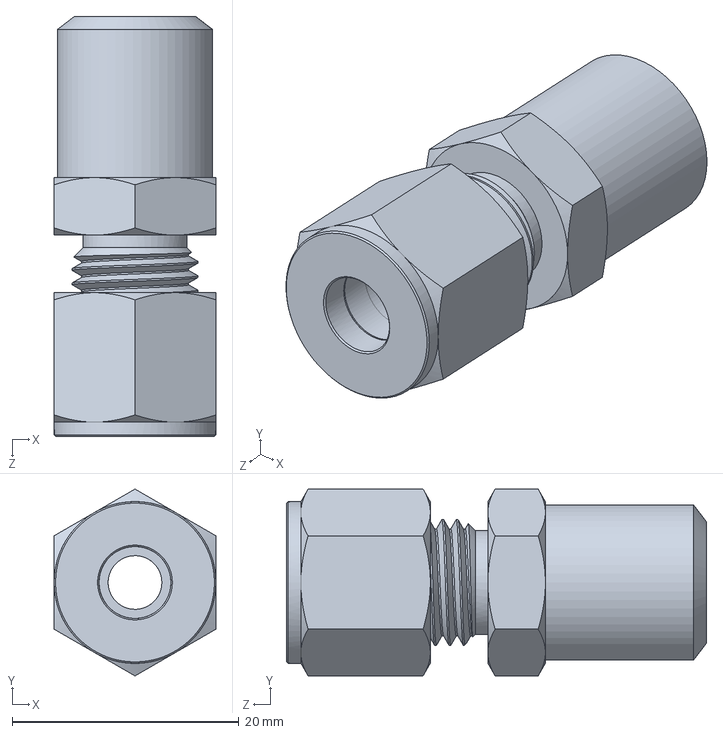
[picture p62: CAD file, 2016-08-10]
setup/New Seebeck System Parts/yor-lok butt weld fitting.SLDPRT
14.3 x 16.5 x 37.1 mm
