bobbymckinney/seebeck_measurement/setup/New Seebeck System Parts/KF50 Flange.SLDPRT

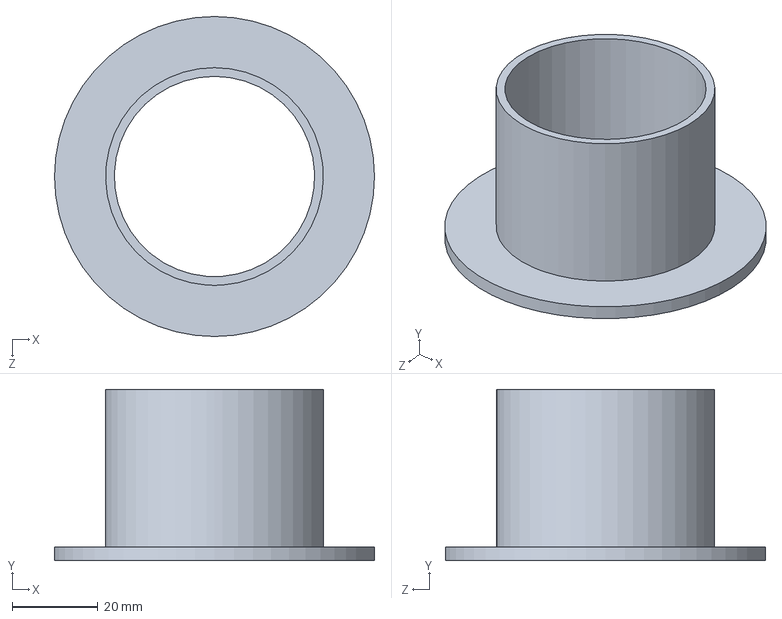
[picture p63: CAD file, 2016-08-10]
setup/New Seebeck System Parts/KF50 Flange.SLDPRT
74.7 x 40.0 x 74.7 mm
