bobbymckinney/seebeck_measurement/setup/New Seebeck System Parts/Top Cu Block.SLDPRT

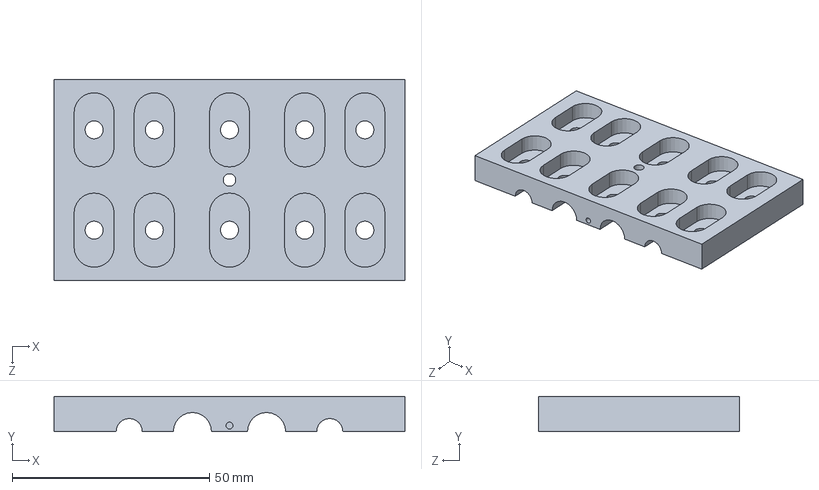
[picture p64: CAD file, 2016-08-10]
setup/New Seebeck System Parts/Top Cu Block.SLDPRT
88.9 x 8.89 x 50.8 mm
