bobbymckinney/seebeck_measurement/setup/New Seebeck System Parts/Ceramic Standoff 1in Length.SLDPRT

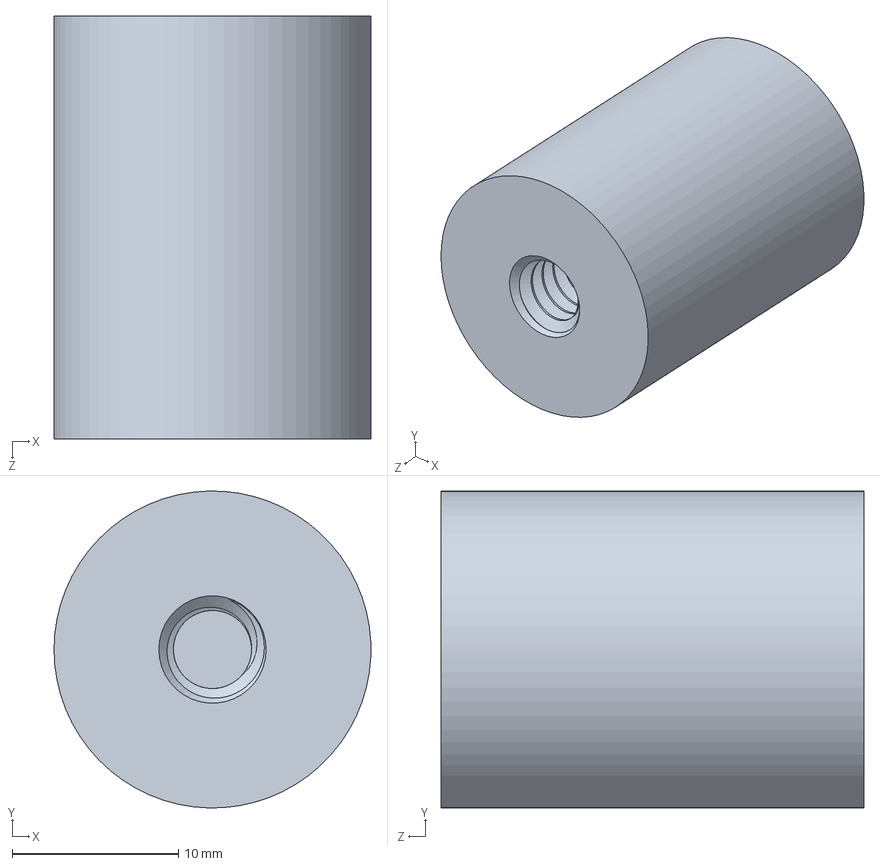
[picture p65: CAD file, 2016-08-10]
setup/New Seebeck System Parts/Ceramic Standoff 1in Length.SLDPRT
19.1 x 19.0 x 25.4 mm
