bobbymckinney/seebeck_measurement/setup/New Seebeck System Parts/ISO 63 Half Nipple.SLDPRT

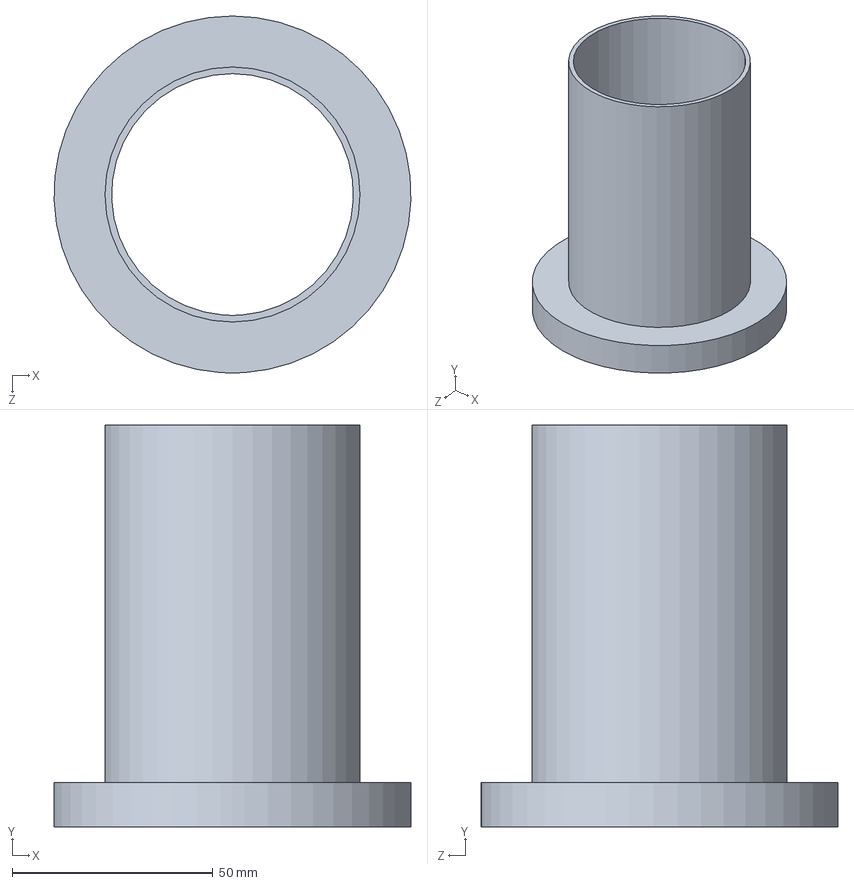
[picture p66: CAD file, 2016-08-10]
setup/New Seebeck System Parts/ISO 63 Half Nipple.SLDPRT
88.9 x 100.1 x 88.9 mm
