bobbymckinney/seebeck_measurement/setup/New Seebeck System Parts/Quarter 20 1.5in Rod.SLDPRT

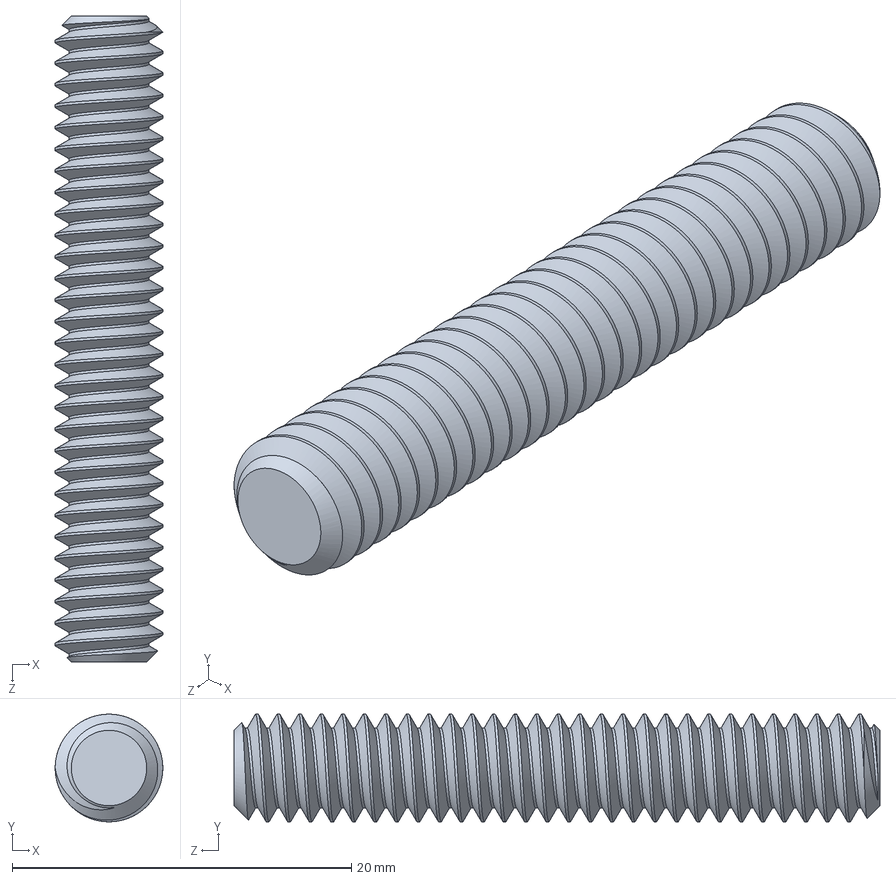
[picture p67: CAD file, 2016-08-10]
setup/New Seebeck System Parts/Quarter 20 1.5in Rod.SLDPRT
6.35 x 6.35 x 38.1 mm
