bobbymckinney/seebeck_measurement/setup/New Seebeck System Parts/Stainless Steel Mount.SLDPRT

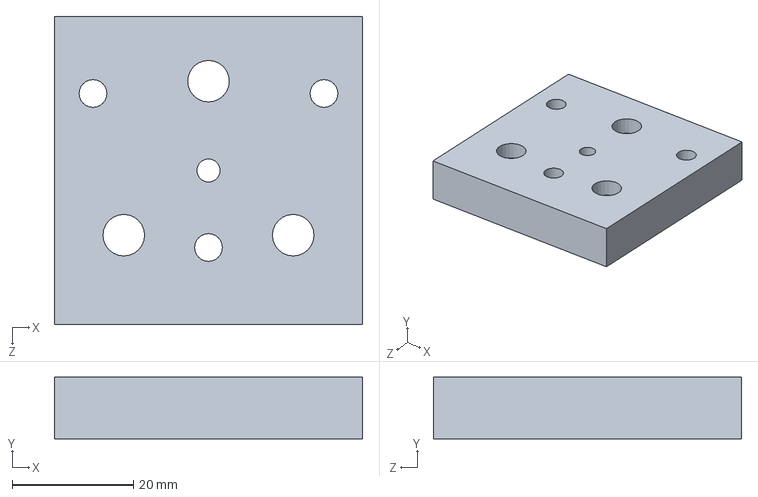
[picture p68: CAD file, 2016-08-10]
setup/New Seebeck System Parts/Stainless Steel Mount.SLDPRT
50.8 x 10.2 x 50.8 mm
