bobbymckinney/seebeck_measurement/setup/New Seebeck System Parts/8020 1ft Rod.SLDPRT

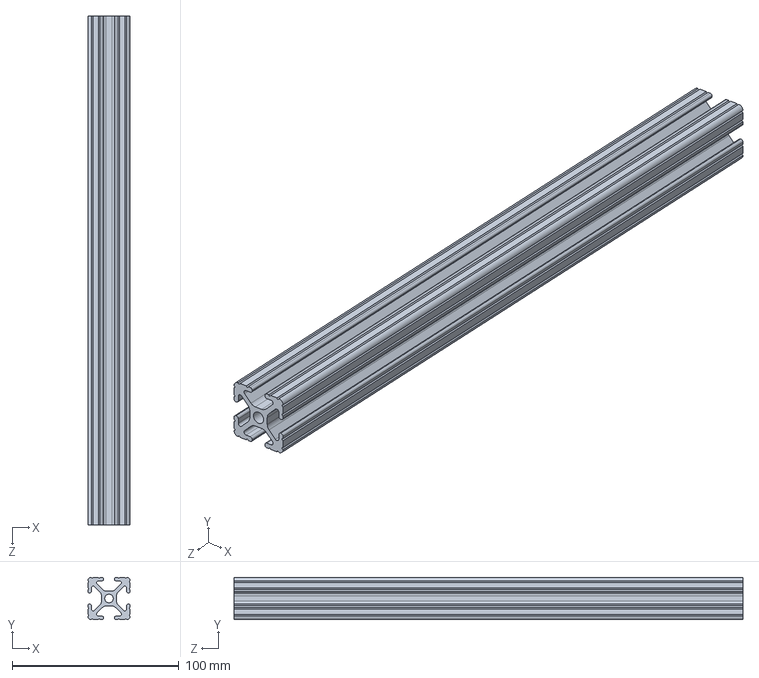
[picture p69: CAD file, 2016-08-10]
setup/New Seebeck System Parts/8020 1ft Rod.SLDPRT
25.4 x 25.4 x 304.8 mm
