bobbymckinney/seebeck_measurement/setup/New Seebeck System Parts/ISO-K Blank Flange.SLDPRT

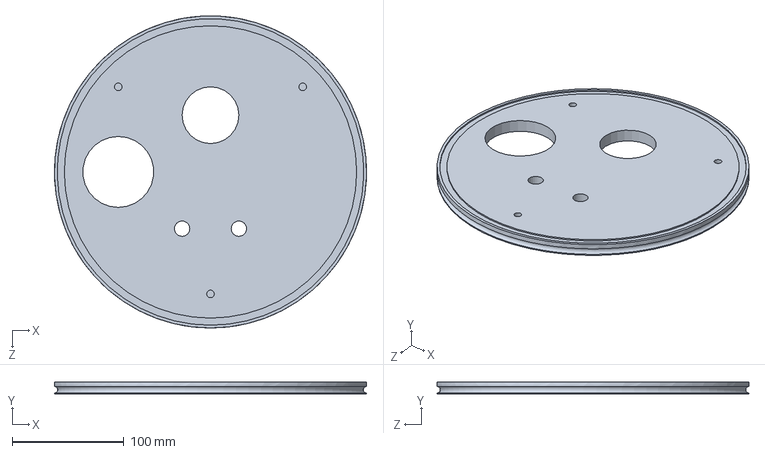
[picture p70: CAD file, 2016-08-10]
setup/New Seebeck System Parts/ISO-K Blank Flange.SLDPRT
279.3 x 11.1 x 279.3 mm
