bobbymckinney/seebeck_measurement/setup/New Seebeck System Parts/38in 16 Thread Rod.SLDPRT

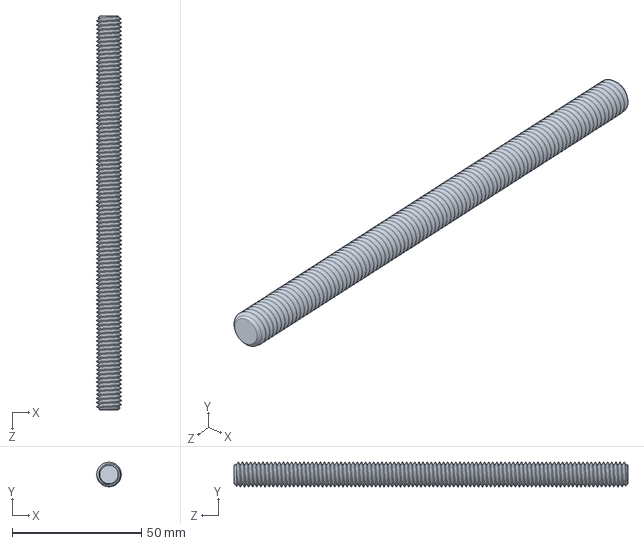
[picture p71: CAD file, 2016-08-10]
setup/New Seebeck System Parts/38in 16 Thread Rod.SLDPRT
9.53 x 9.53 x 152.4 mm
