bobbymckinney/seebeck_measurement/setup/New Seebeck System Parts/Quarter 20 3in Rod.SLDPRT

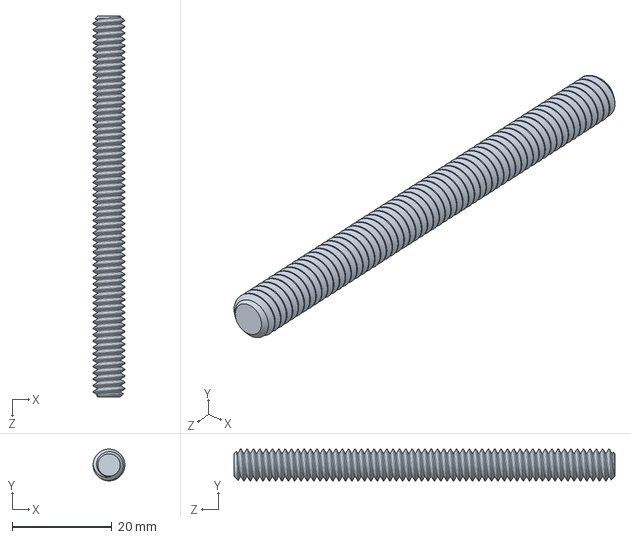
[picture p72: CAD file, 2016-08-10]
setup/New Seebeck System Parts/Quarter 20 3in Rod.SLDPRT
6.35 x 6.35 x 76.2 mm
