bobbymckinney/seebeck_measurement/setup/New Seebeck System Parts/Bent Cooling Pipe.SLDPRT

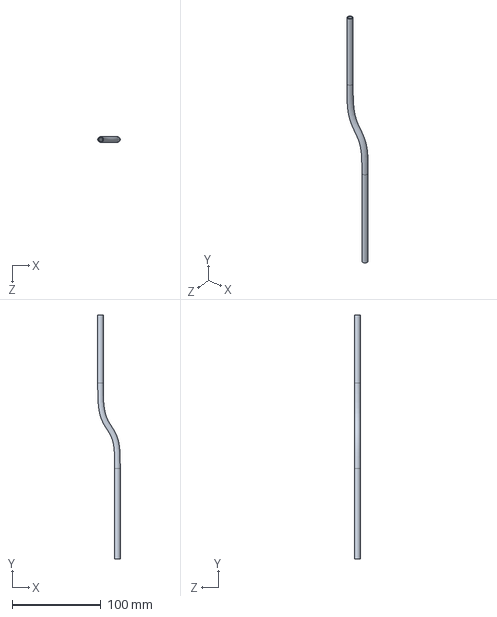
[picture p73: CAD file, 2016-08-10]
setup/New Seebeck System Parts/Bent Cooling Pipe.SLDPRT
25.4 x 274.3 x 6.35 mm
