bobbymckinney/seebeck_measurement/(list of files, cad)

Other CAD files:
setup/lowtemp_design/mastercam/aluminum plate.SLDPRT
setup/hightemp2/mastercam/cu_block1_top_holes.SLDPRT
setup/hightemp2/mastercam/cu_block2_bottom.SLDPRT
setup/hightemp2/mastercam/cu_block2_side.SLDPRT
setup/hightemp2/mastercam/cu_block1_top_slots.SLDPRT
setup/redesign_2-29-16/block1.SLDPRT
setup/New Seebeck System Parts/Top SS Disk.SLDPRT
setup/New Seebeck System Parts/832 .625in Length Screw.SLDPRT
setup/New Seebeck System Parts/832 1in Screw.SLDPRT
setup/New Seebeck System Parts/832 2in Length Screw.SLDPRT
setup/New Seebeck System Parts/832 Nut.SLDPRT
setup/New Seebeck System Parts/Quarte 20 Nut.SLDPRT
setup/hightemp2/1420_nut.SLDPRT
setup/hightemp2/832_nut.SLDPRT
setup/hightemp2/832_screw.SLDPRT
setup/lowtemp_design/ceramic_washer.SLDPRT
setup/lowtemp_design/plastic_spacer.STL
setup/old designs/ClampHeater.dwg
setup/old designs/ClampHeater2.dwg
setup/old designs/ClampHeater2_recover.dwg
setup/old designs/ClampHeater3.dwg
setup/old designs/Seebeck Assebly Ajusted (1).SLDDRW
setup/old designs/Seebeck Assebly Ajusted.SLDDRW
setup/old designs/Seebeck Assembly (1).SLDDRW
setup/old designs/Seebeck Assembly WO Hardware.SLDASM
setup/old designs/Seebeck Assembly WO Hardware.SLDDRW
setup/old designs/Seebeck Assembly.SLDDRW
setup/old designs/Seebeck Lower block.SLDPRT.SLDASM
setup/old designs/Seebeck Middle Block.SLDPRT
setup/old designs/seebeck bushings.SLDPRT
setup/redesign_2-29-16/ss_nut_large.SLDPRT
setup/redesign_2-29-16/ss_nut_small.SLDPRT
setup/redesign_2-29-16/ss_screw_large.SLDPRT
setup/redesign_2-29-16/ss_screw_small (Bobby McKinney's conflicted copy 2016-02-29).SLDPRT
setup/redesign_2-29-16/ss_screw_small.SLDPRT
