bobbymckinney/seebeck_measurement/setup/New Seebeck System Parts/New Seebeck System Assembly Copy.PNG

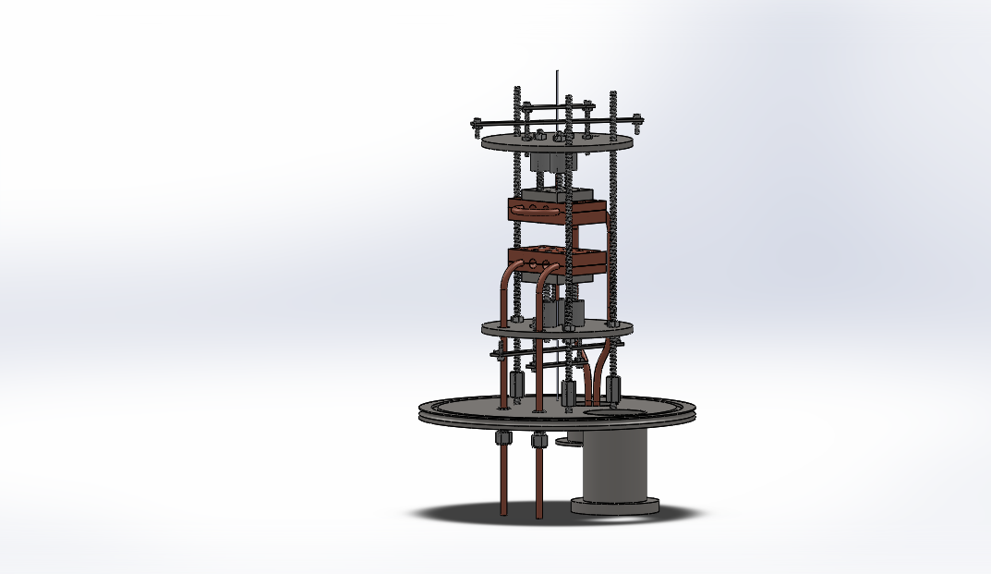
setup/New Seebeck System Parts/New Seebeck System Assembly Copy.PNG
