bobbymckinney/seebeck_measurement/setup/TE_Poster_2016-07-22/hall_assembly.PNG

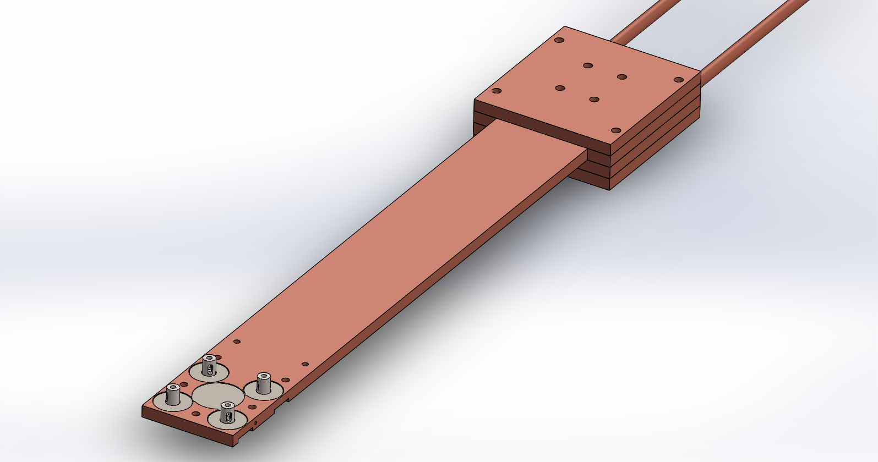
setup/TE_Poster_2016-07-22/hall_assembly.PNG
