bobbymckinney/seebeck_measurement/setup/old designs/ClampHeater2.pdf

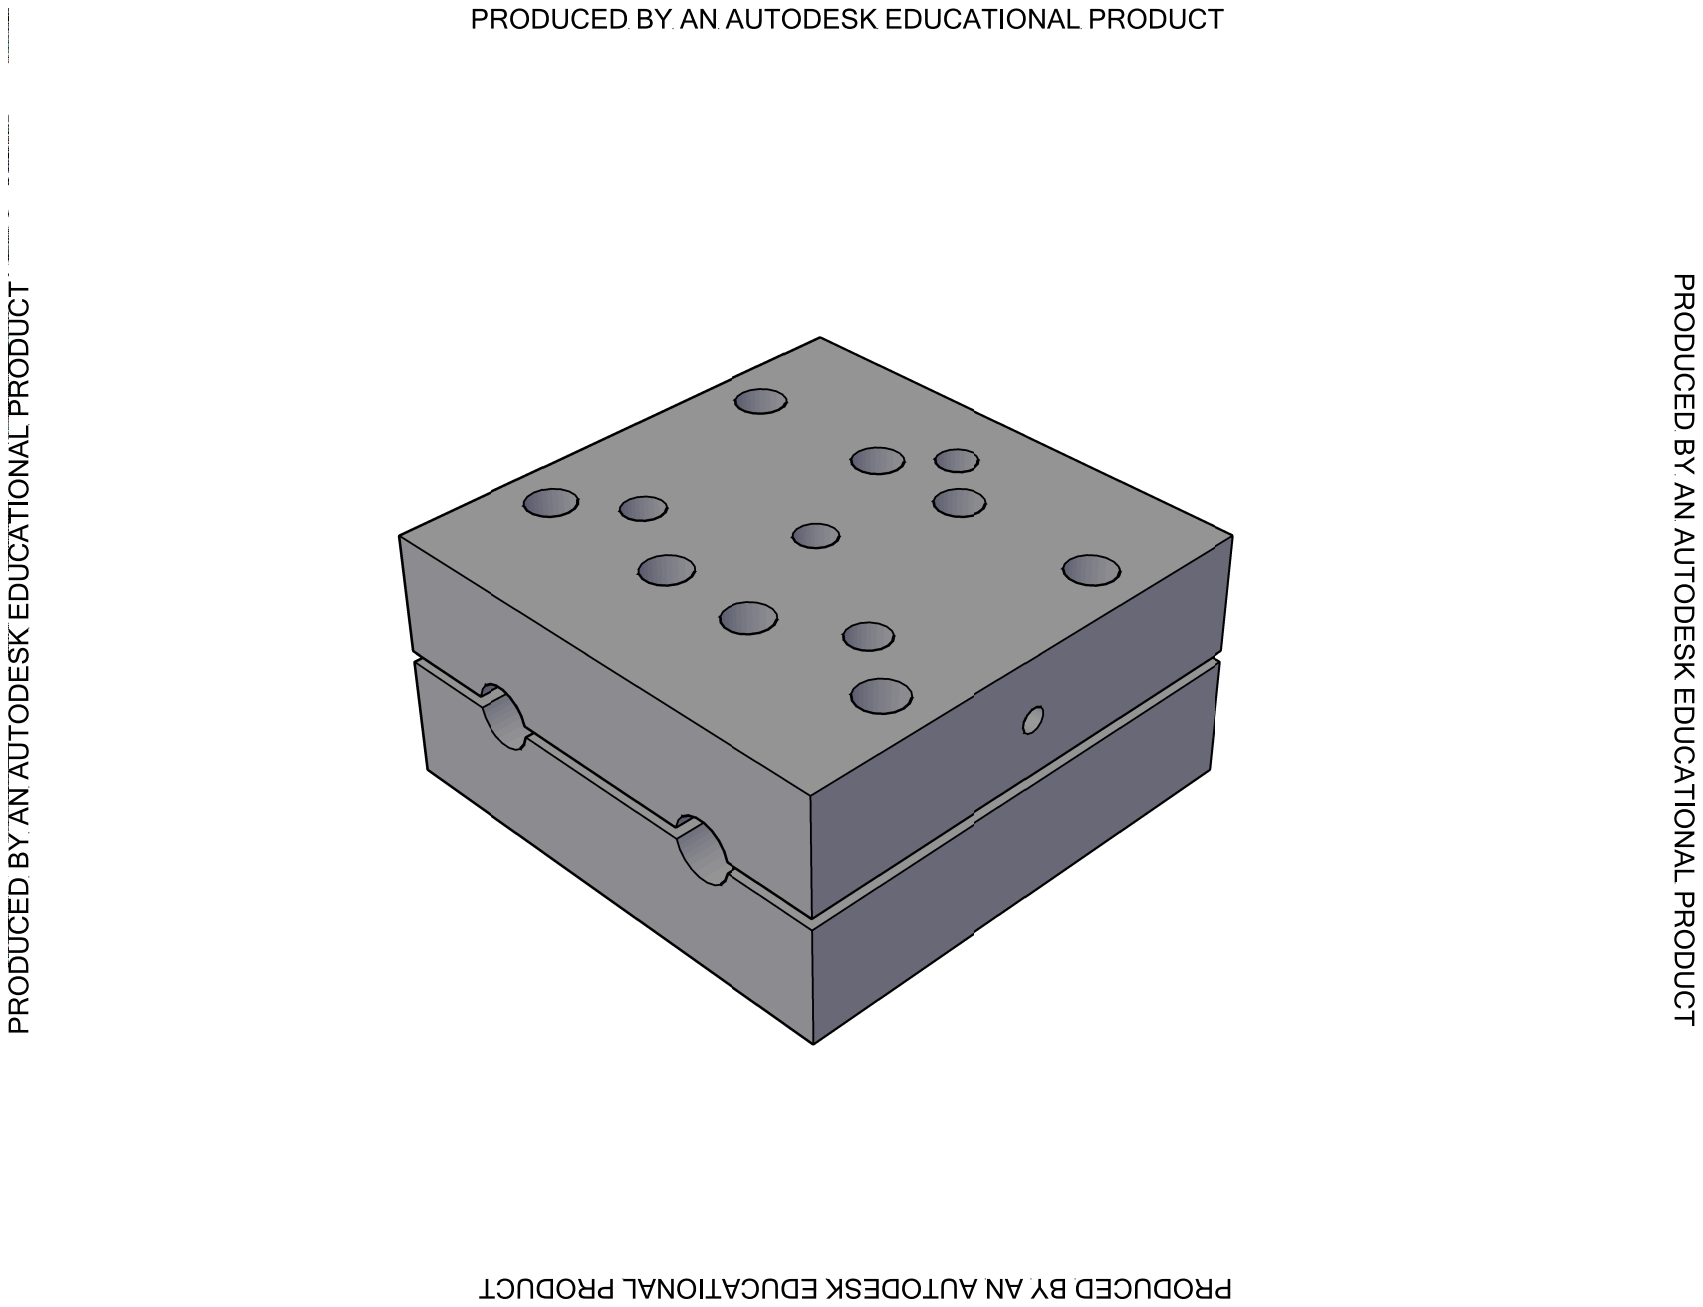
[picture p77: page 1]
