bobbymckinney/seebeck_measurement/setup/old designs/ClampHeater2_concept.pdf

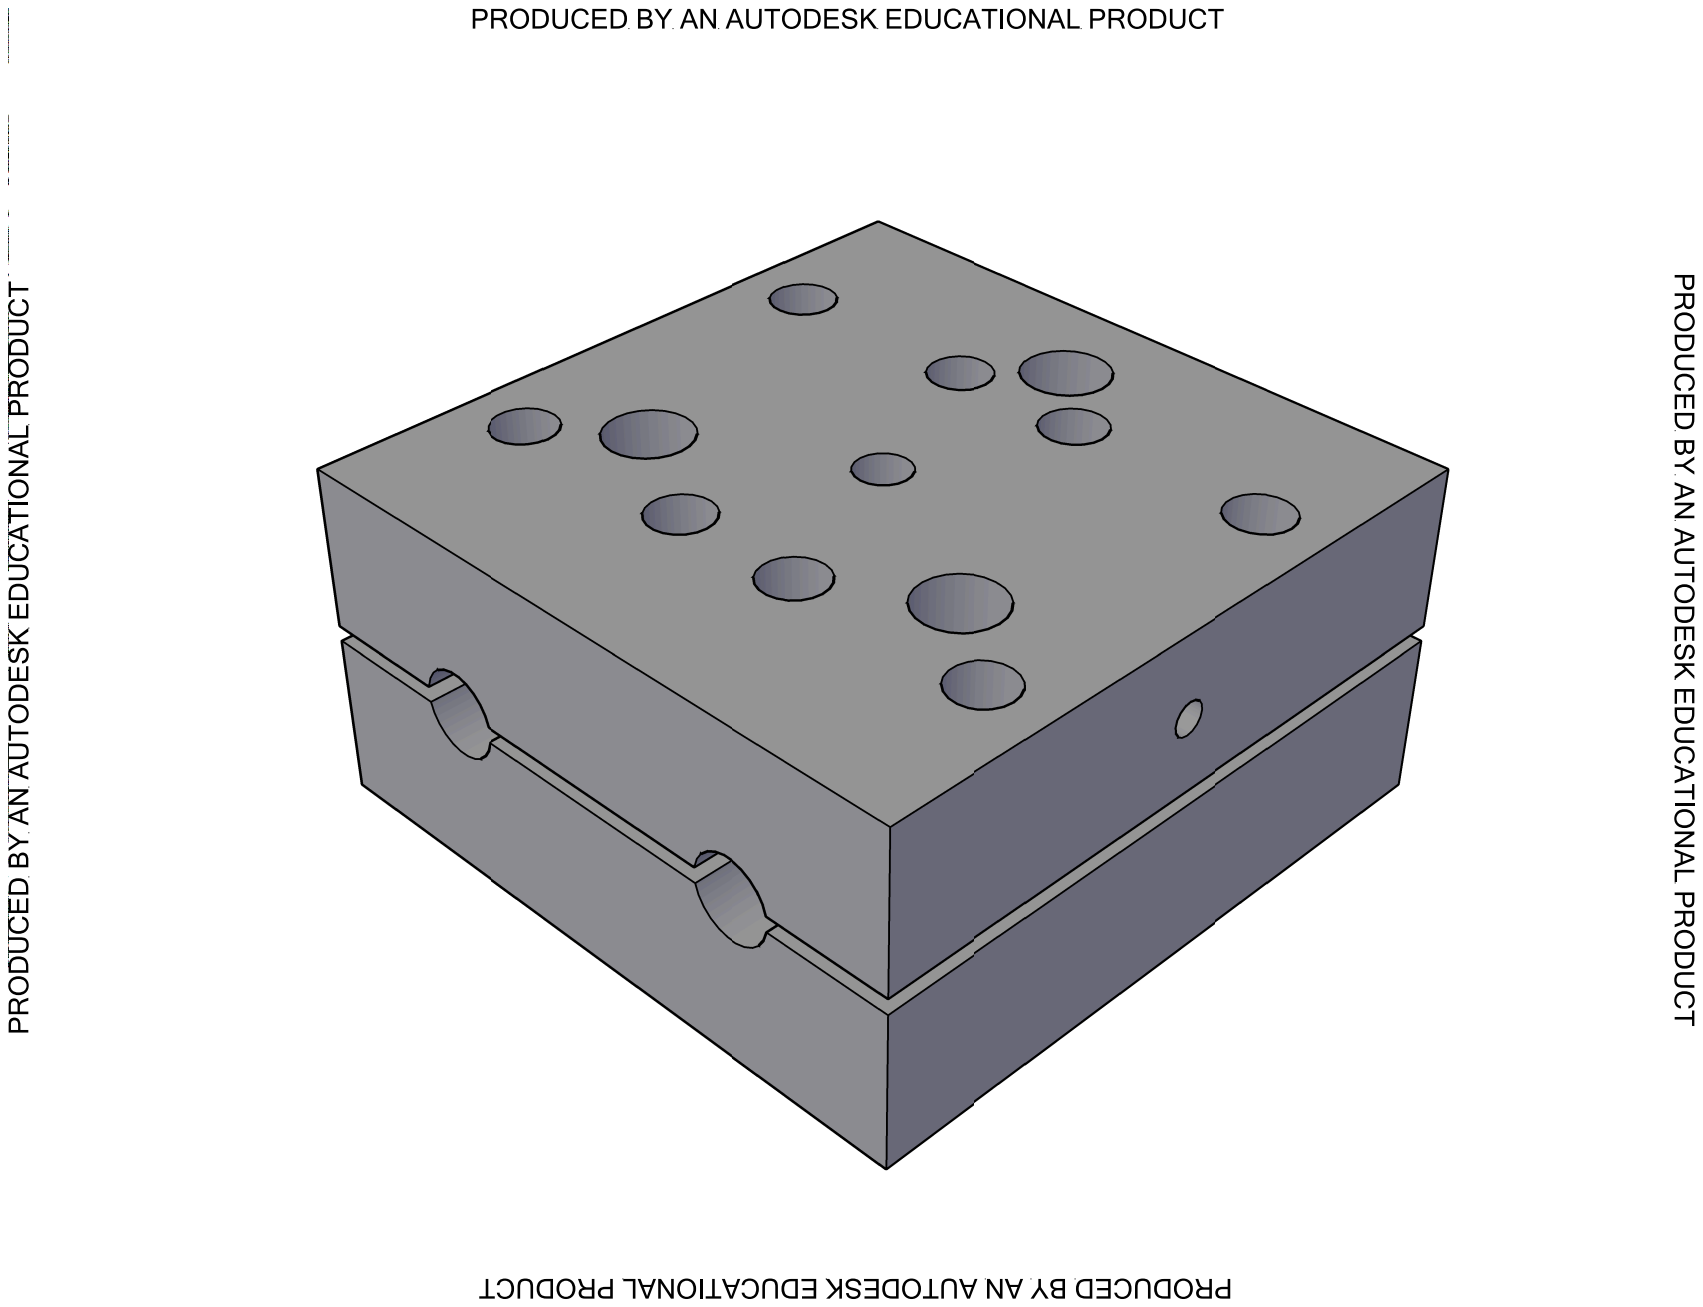
[picture p78: page 1]
