bobbymckinney/seebeck_measurement/setup/old designs/ClampHeater2_dim.pdf

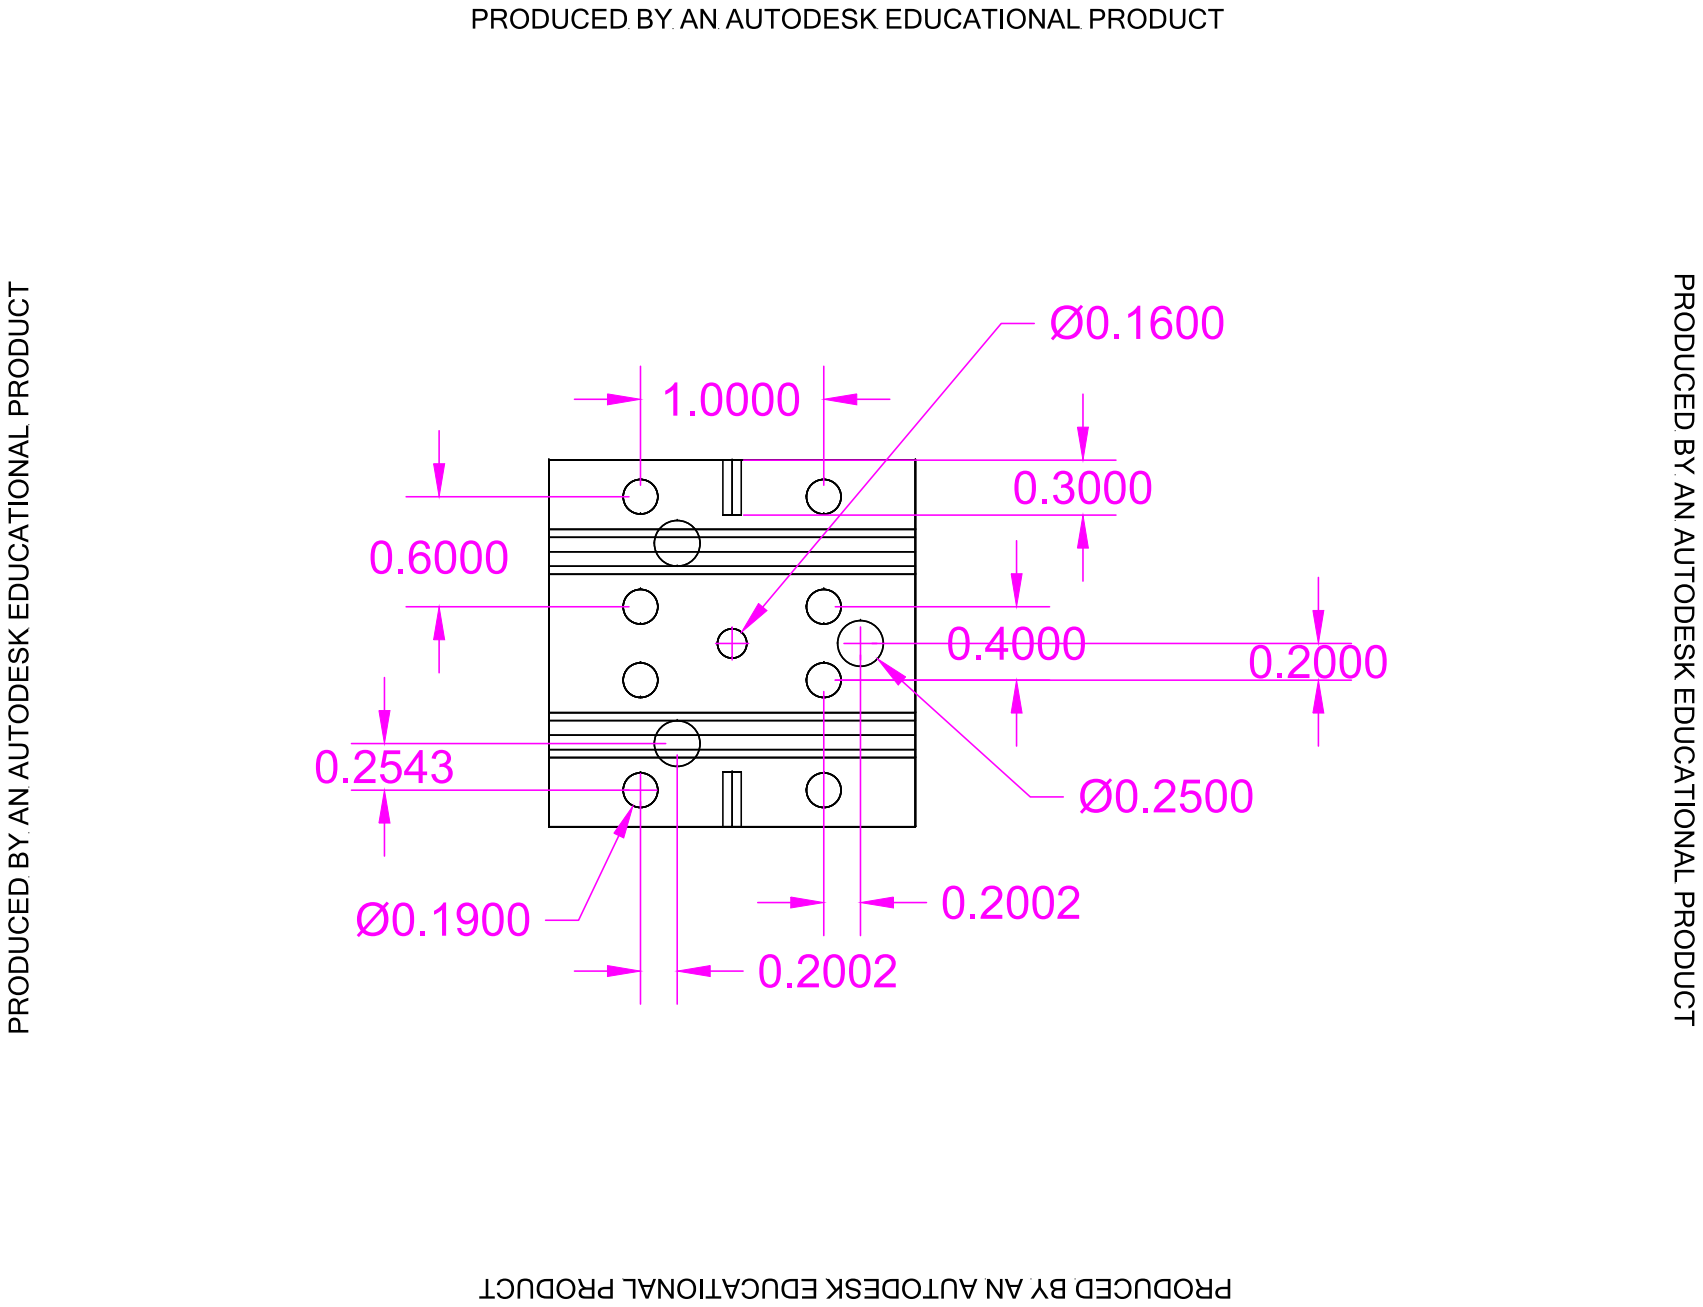
[picture p79: page 1]
