bobbymckinney/seebeck_measurement/setup/old designs/ClampHeater3_overview.pdf

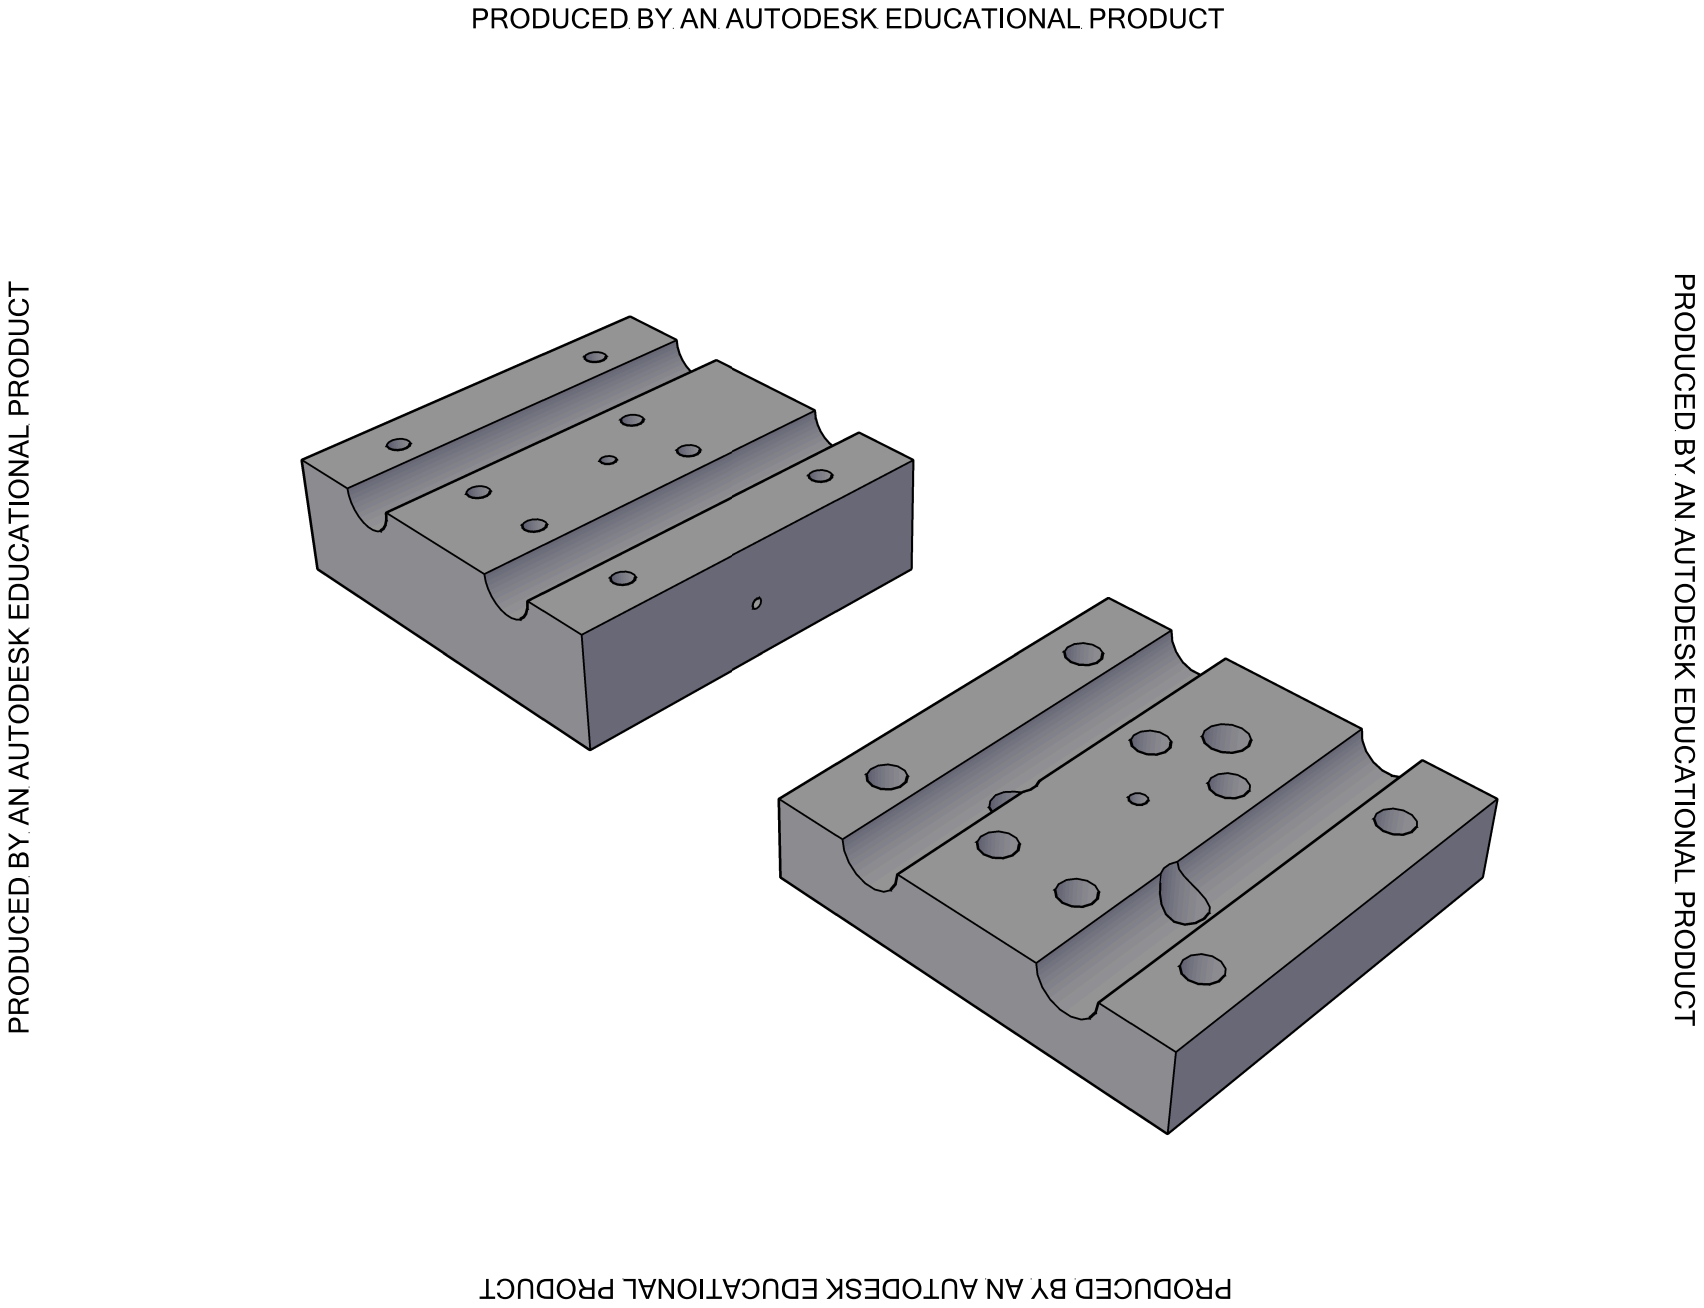
[picture p80: page 1]
