bobbymckinney/seebeck_measurement/setup/old designs/ClampHeater3_overview_small.pdf

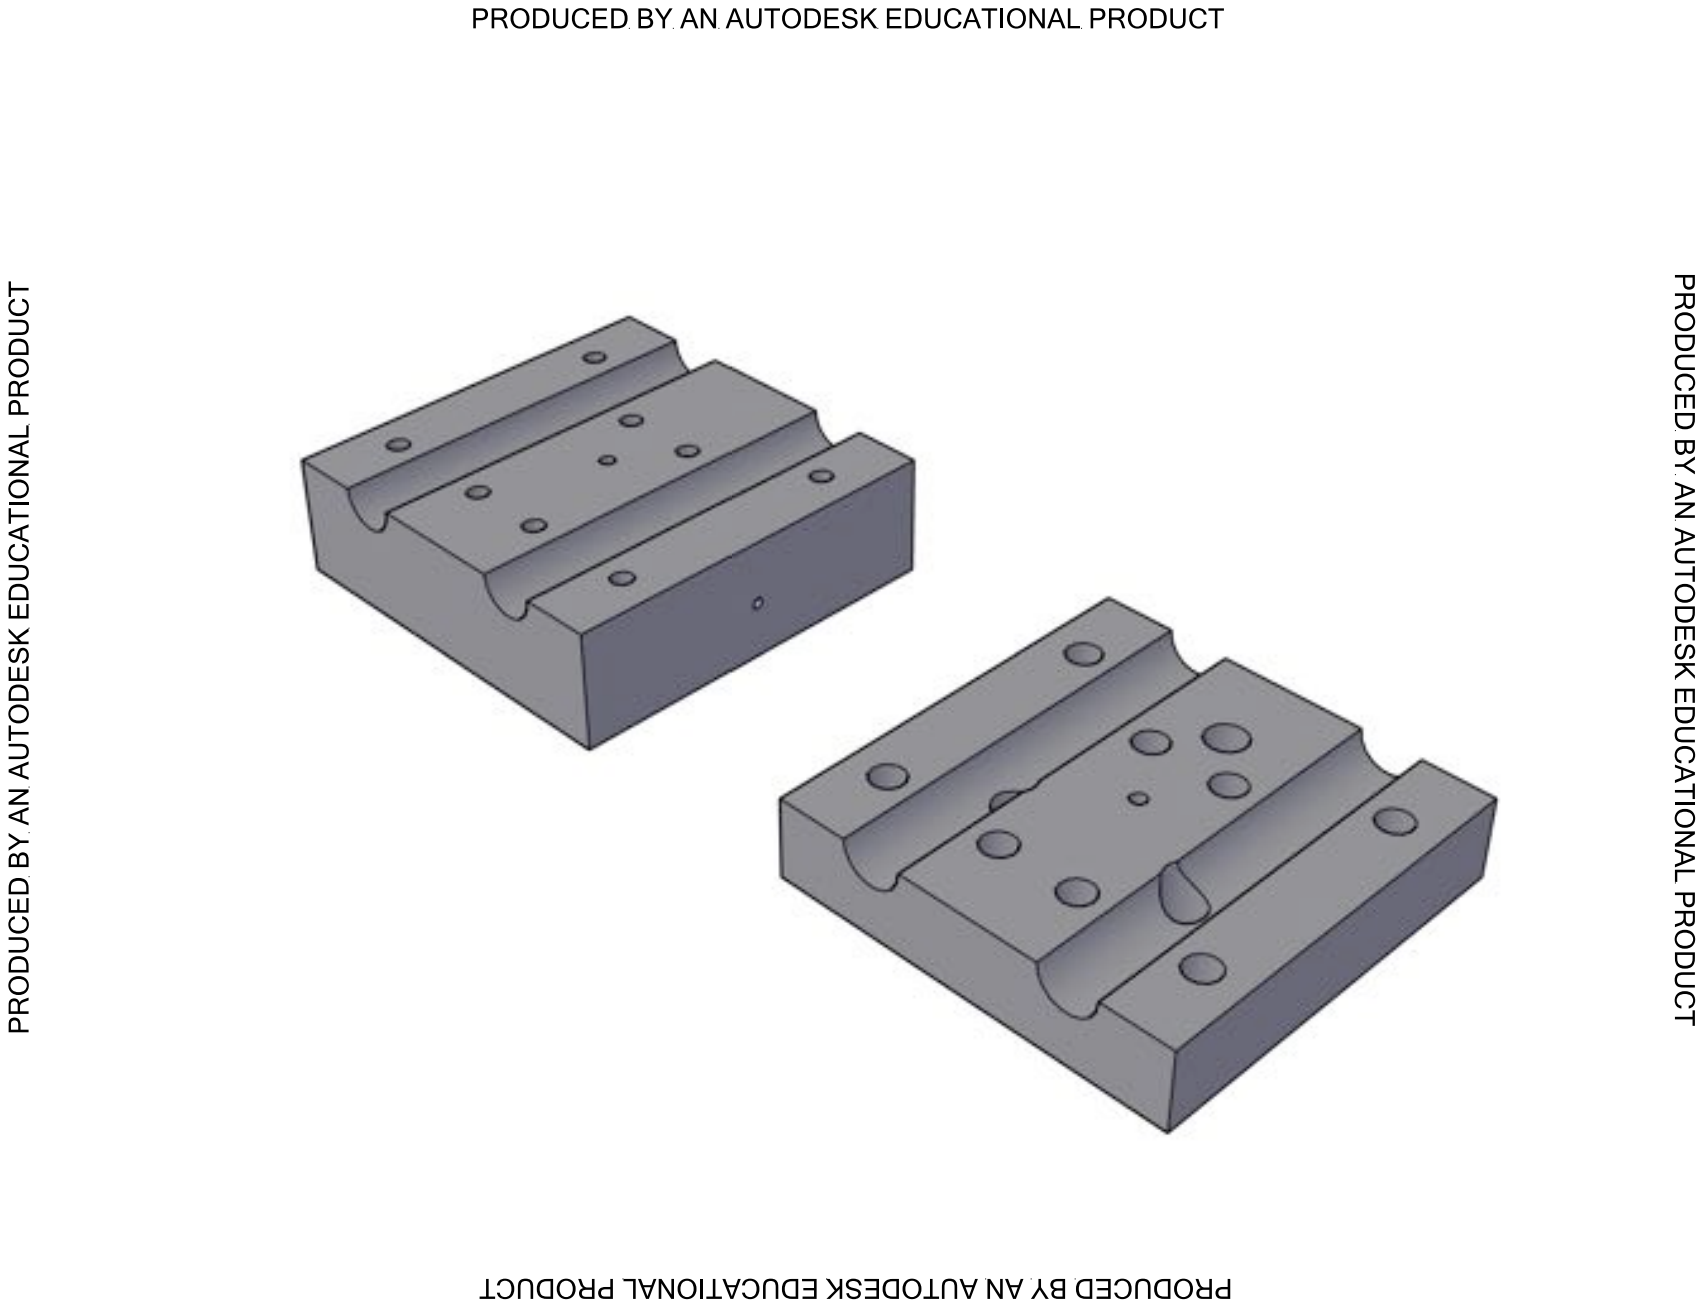
[picture p81: page 1]
