bobbymckinney/seebeck_measurement/setup/old designs/ClampHeater3_sideview.pdf

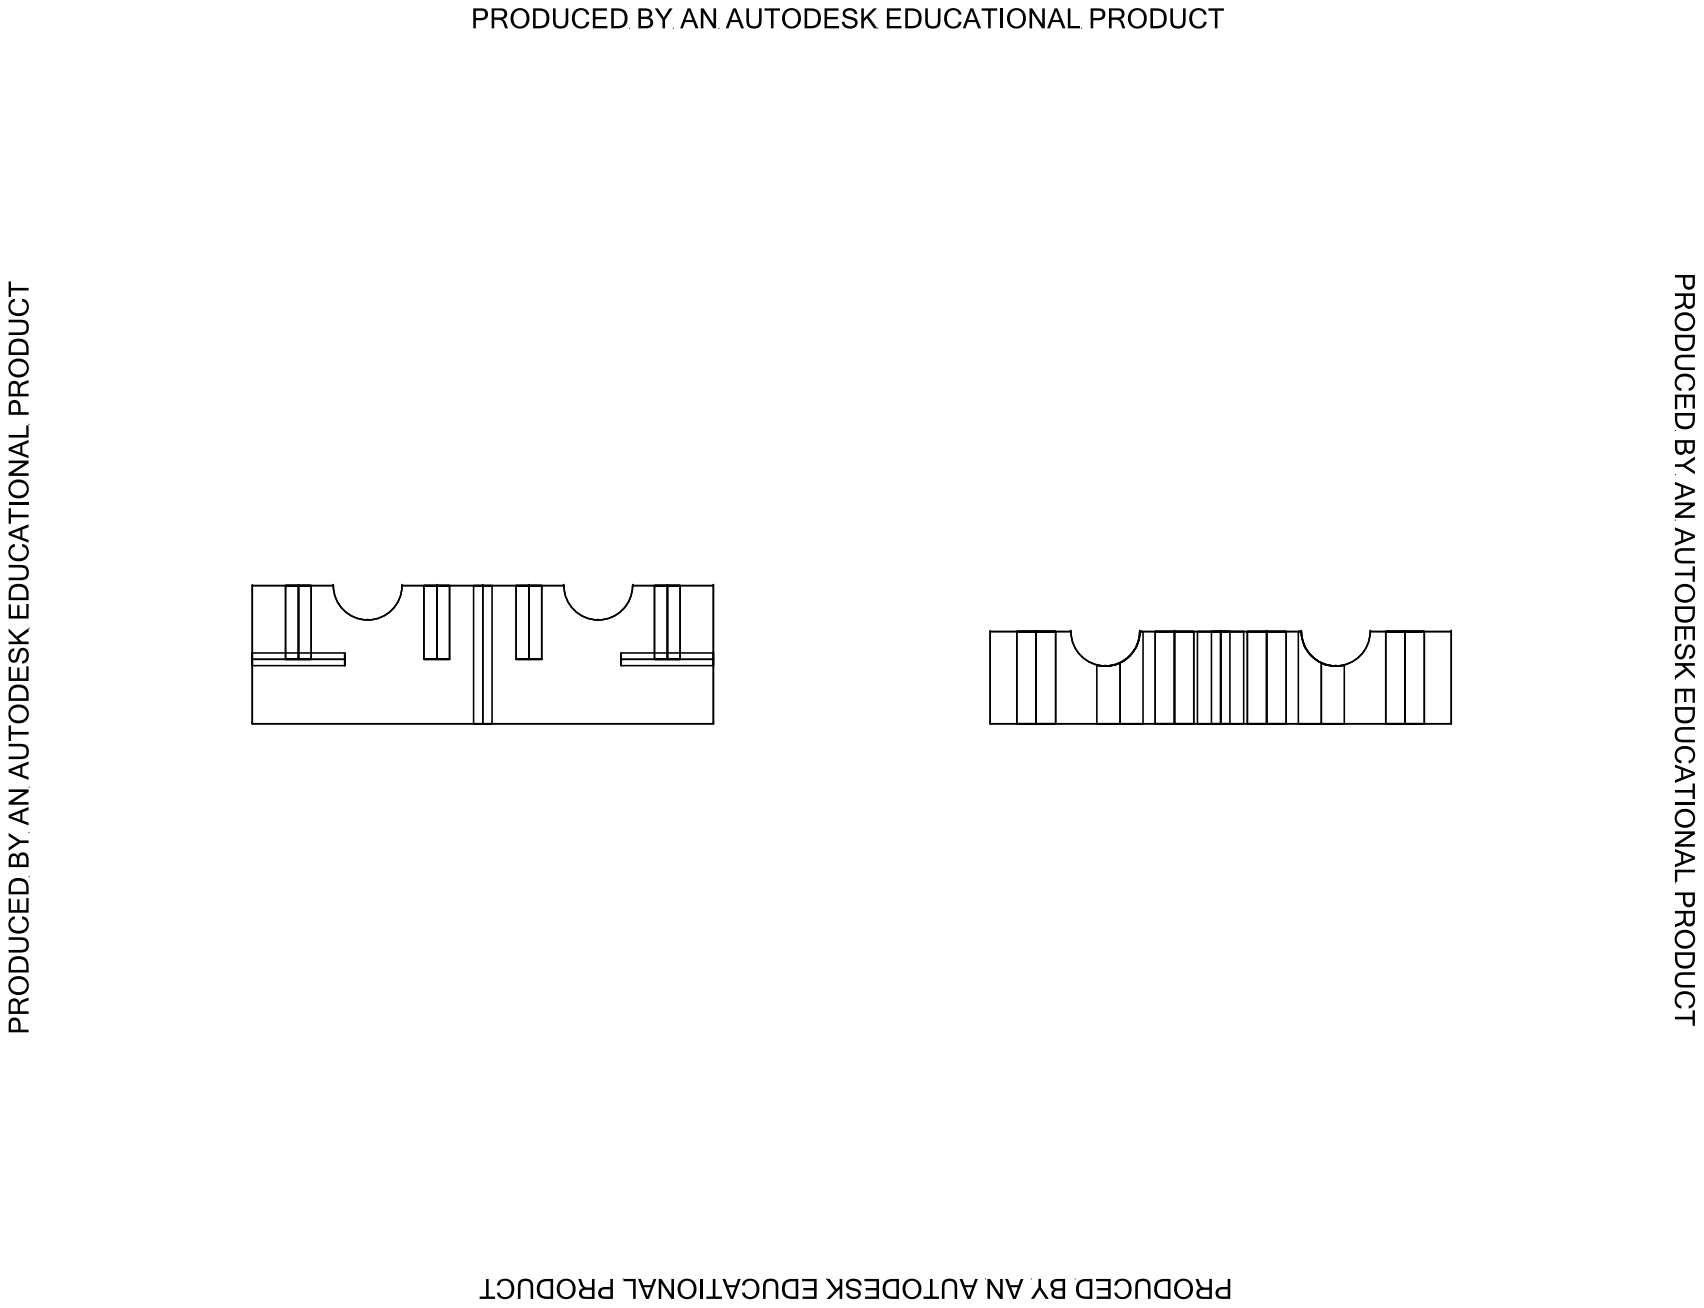
[picture p82: page 1]
