bobbymckinney/seebeck_measurement/setup/old designs/ClampHeater3_topview.pdf

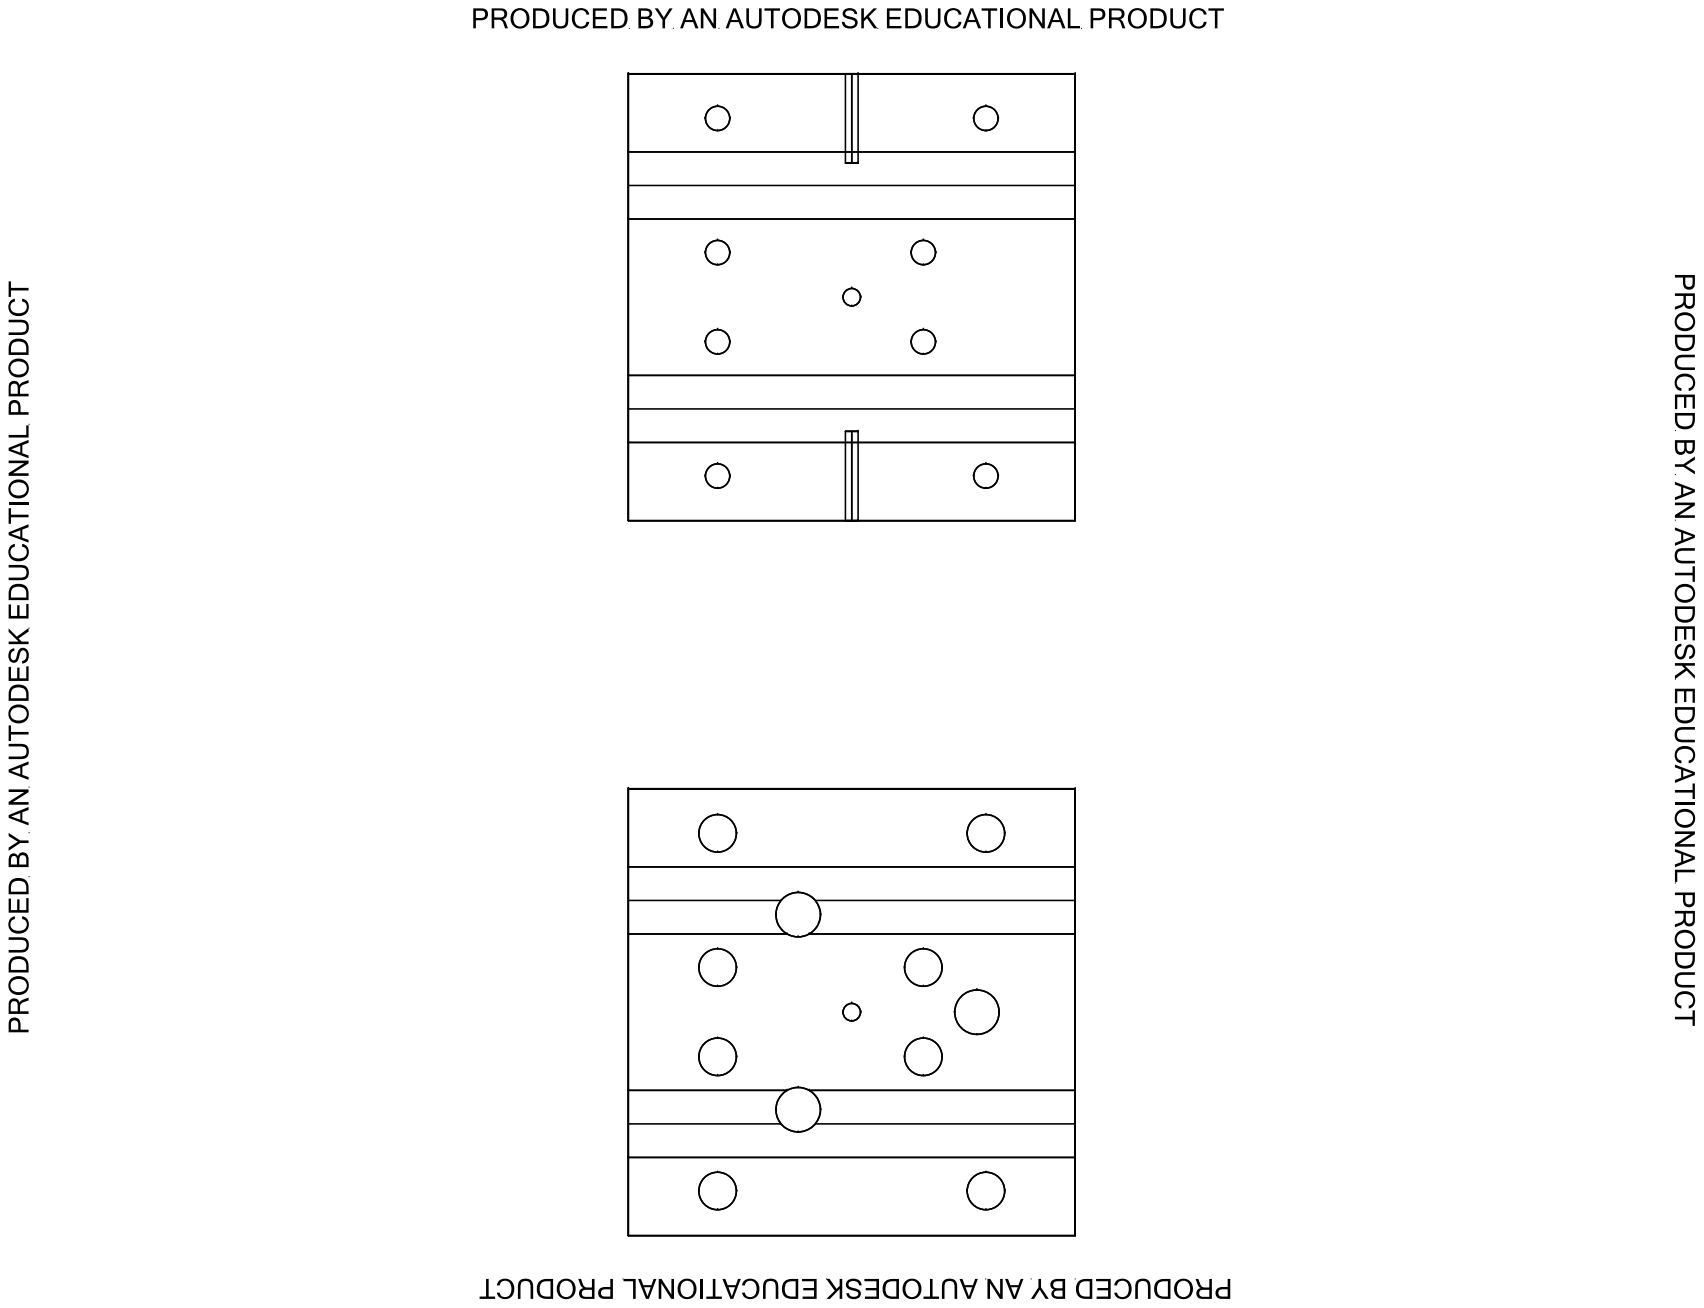
[picture p83: page 1]
