bobbymckinney/seebeck_measurement/setup/old designs/ClampHeaterTopView.pdf

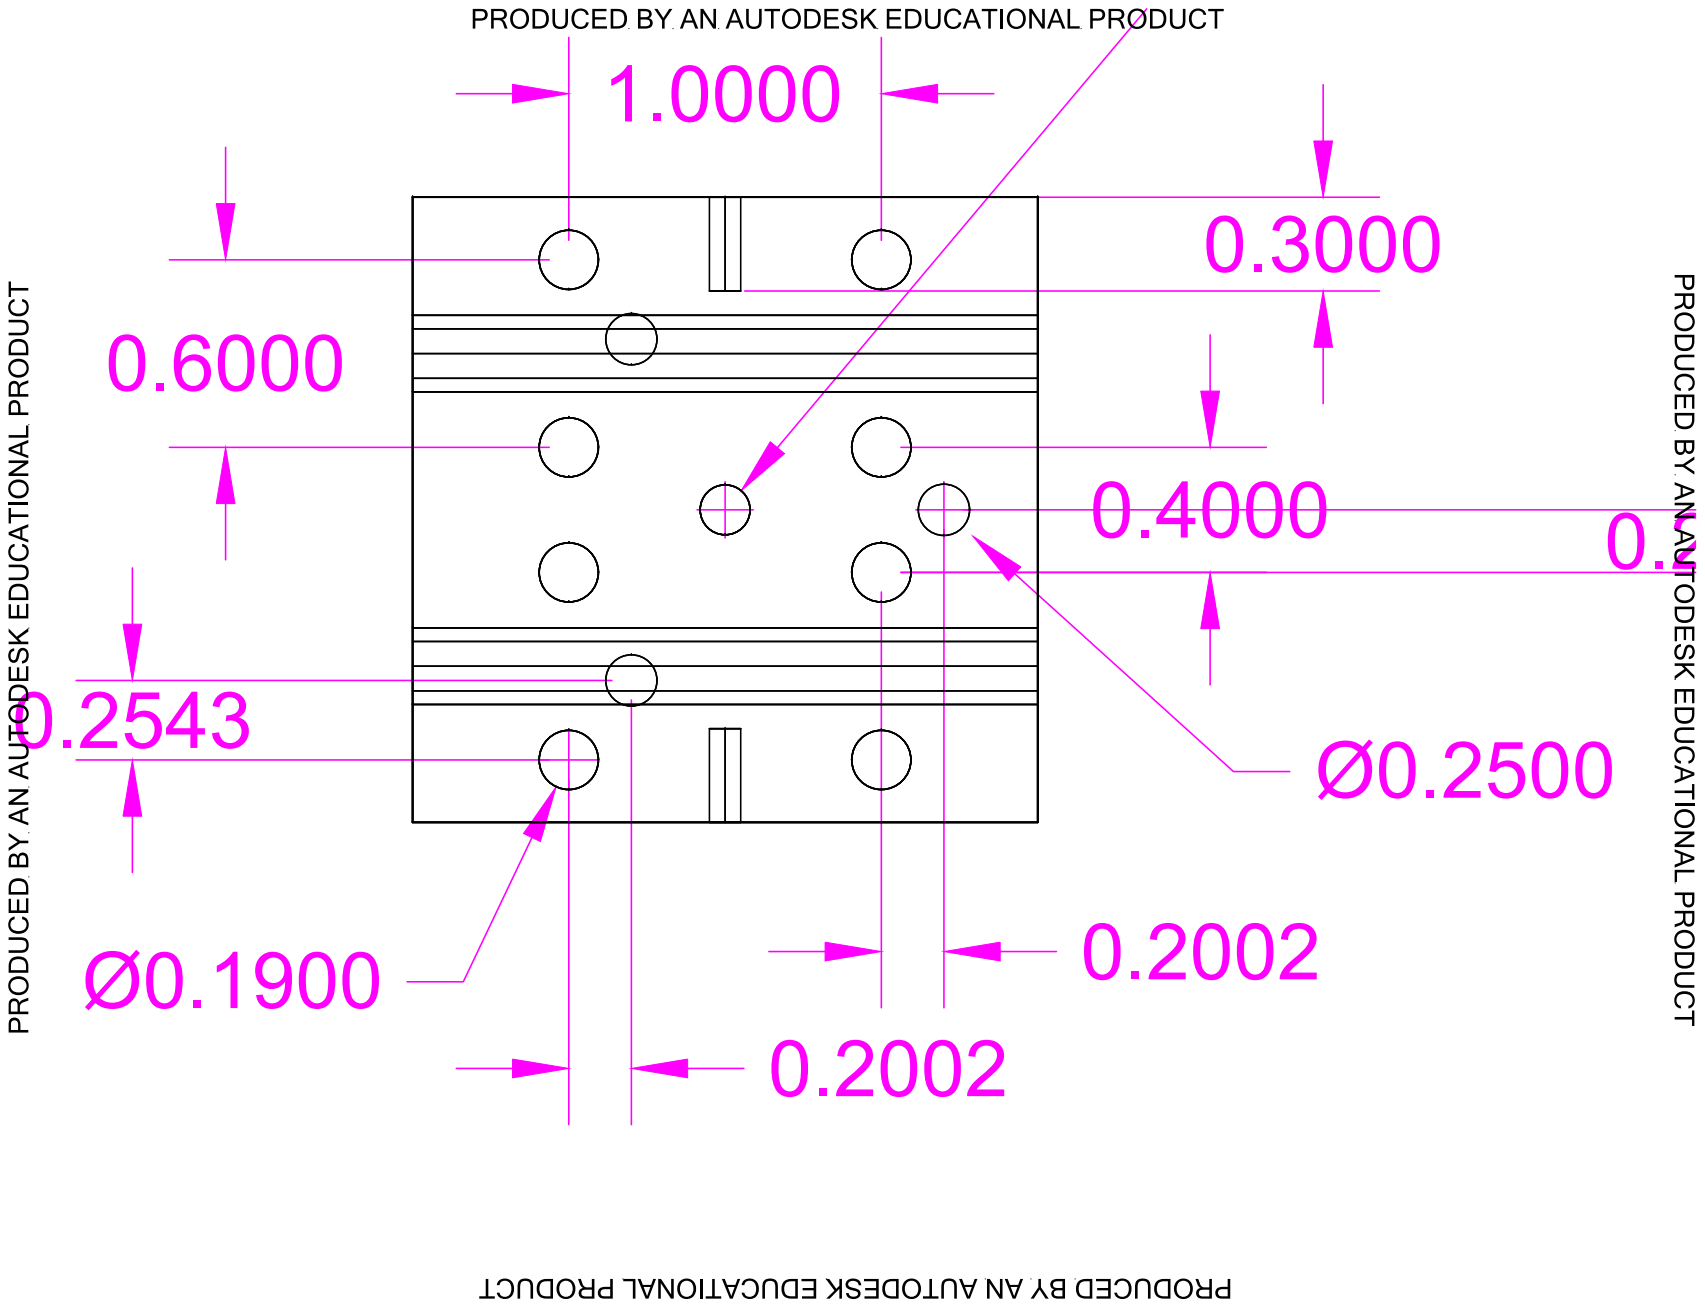
[picture p84: page 1]
