bobbymckinney/seebeck_measurement/(commit log)

2015-08-19 google drive synce with lab
    [ClampHeater.dwg, ClampHeater2.dwg, ClampHeater2_recover.dwg, ClampHeater3.dwg, Seebeck Assebly Ajusted (1).SLDDRW, Seebeck Assebly Ajusted.SLDDRW, Seebeck Assembly (1).SLDDRW, Seebeck Assembly WO Hardware.SLDASM]
2015-08-27 Changed seebeck tolerance and stability to read from PID thermocouples instead of sample thermocouples
    [SeebeckGUIv4.py]
2015-09-01 Minor bug fixes and moved old versions to separate folder.
    [SeebeckGUIv3.py, SeebeckGUIv5.py, Seebeck_Processing_v5.py]
2015-09-03 added a function that accounts for discrepancy between heater blocks and sample adn sets sample to correct temperature
    [SeebeckGUIv5.py]
2015-09-03 changed heater correction to 2C instead of 3C
    [SeebeckGUIv5.py]
2015-09-13 updated version 5 to independently control each pid in order to achieve stability before measurement. moved older versions to separate folder.
    [SeebeckGUIv4.py, SeebeckGUIv6.py]
2015-09-29 Modified current temp control to avoid overcorrection down
    [SeebeckGUIv6.py]
2015-09-30 separated temperature stability check for pid A and pid B
    [SeebeckGUIv6.py]
2015-10-05 switched directory
2015-10-07 Changed Delta T measurement to use less points. Reduced number of points for temperature stability calculation.
    [SeebeckGUIv6.py]
2015-11-20 New version 7 of Seebeck GUI. This updated version now uses the temperature of the sample directly forheating control. Block temperatures are kept as a safety check. Other minor fixes.
    [SeebeckGUIv7.py]
2016-01-14 moved v6 to old versions folder, started program from low temp setup.
    [aluminum_long_plate.SLDPRT, aluminum_short_plate.SLDPRT, aluminum_standoff.SLDPRT, calmpon_shaft_collar.SLDPRT, ceramic_standoff.SLDPRT, ceramic_thermocouple.SLDPRT, ceramic_washer.SLDPRT, compression spring.SLDPRT]
2016-02-09 Wrote bare bones command line version of Seebeck program with all traces of GUI removed
2016-08-10 big update including new design and poster
    [1420_nut.SLDPRT, 200C_profile.csv, 225C_profile.csv, 250C_profile.csv, 275C_profile.csv, 3 Way 8020 Connector.SLDPRT, 300C_profile.csv, 325C_profile.csv]
